zuozhuyvzhibo-maker/Tinyriscv_g11/doc/From RTL to GDS 设计流程讲解（中）.pdf

# From RTL to GDS 设计流程讲解（中）

程子艺，华园，陈虹
THU-SIC
2026年5月

## 清华大学集成电路学院《数字集成电路设计与实践》

目录

- 综合

## - 形式验证

- 布局
- 布线

## 清华大学集成电路学院《数字集成电路设计与实践》

# 布局和布线（一）

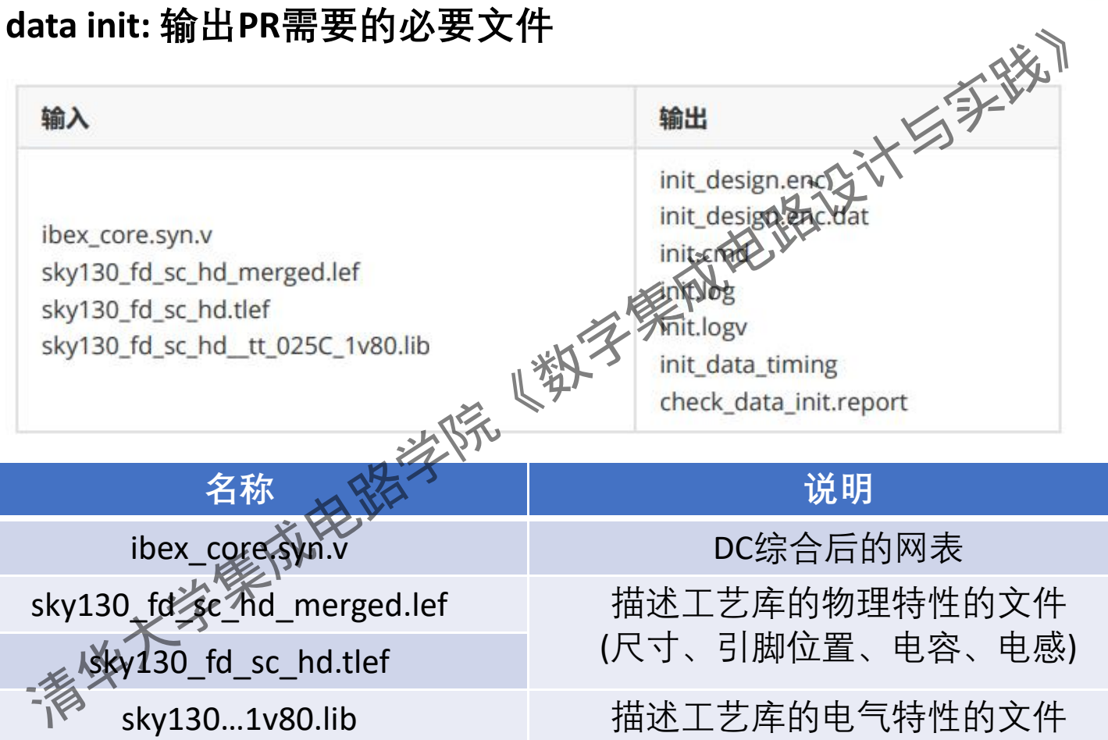
[picture p2: figure]
清华大学集成电路学院《数字集成电路设计与实践》

名称 | 说明
ibex_core.syn.v | DC综合后的网表
sky130_fd_sc_hd_merged.lef | 描述工艺库的物理特性的文件
(尺寸、引脚位置、电容、电感) sky130_fd_sc_hd.tlef
sky130…1v80.lib | 描述工艺库的电气特性的文件 (时序、功耗、电压)
- PR data init: 输出PR需要的必要文件

# 布局和布线（一）

名称 | 说明
init_design.enc | 芯片设计的初始状态信息，
init_design.enc.dat | 如逻辑元素的布局、连接、时序
init.cmd | PR工具的初始化命令和参数
init.log | 记录PR工具的初始化过程和结果
init.logv
init_data_timing | 芯片设计的数据初始化信息，如逻辑 元素的状态、时钟设置
check_data_init.report | 芯片设计的时序分析结果，如时钟频 率、时序路径、时序违规等
- PR data init

## 清华大学集成电路学院《数字集成电路设计与实践》

# 布局和布线（一）

- PR data init

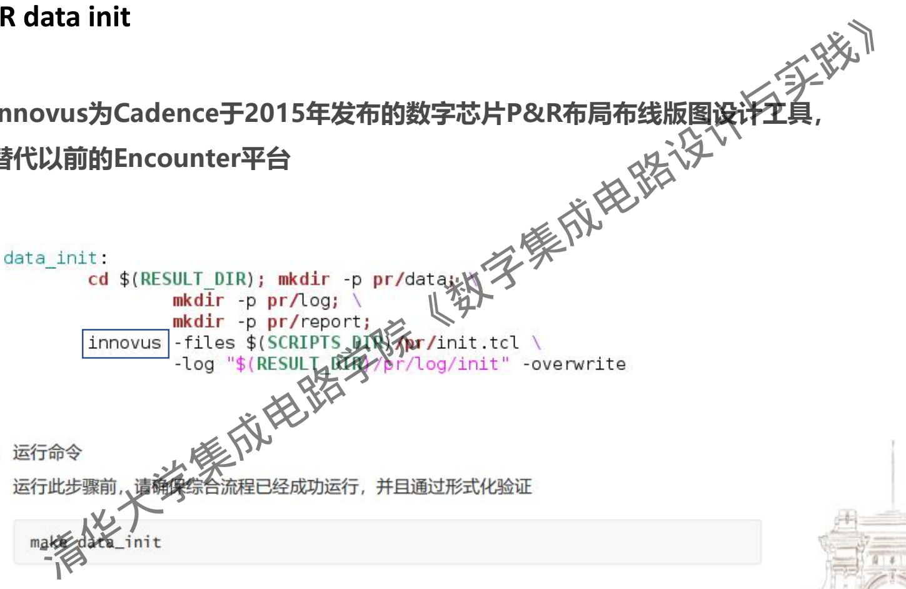
[picture p3: figure]
清华大学集成电路学院《数字集成电路设计与实践》

Innovus为Cadence于2015年发布的数字芯片P&R布局布线版图设计工具， 替代以前的Encounter平台

# 布局和布线（一）

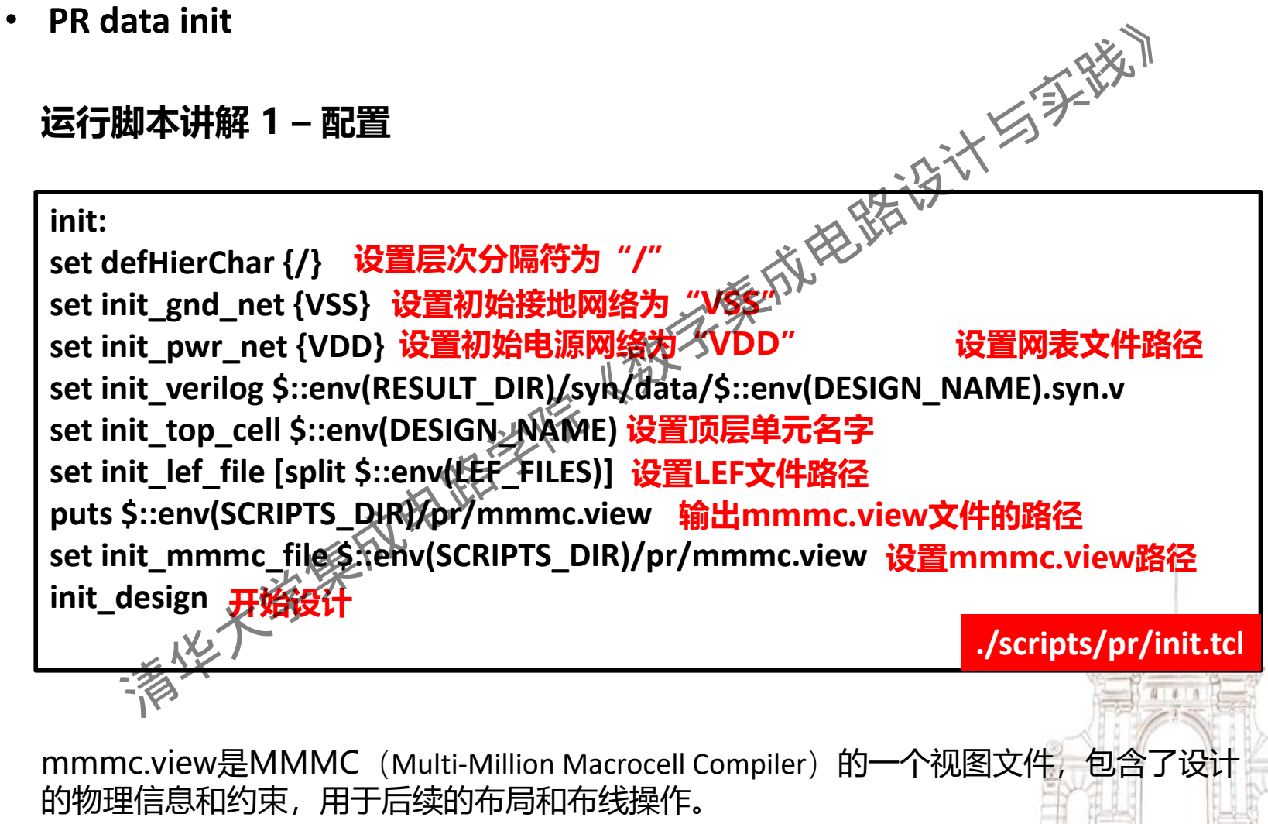
[picture p4: figure]
• PR data init; init: set defHierChar {/} set init_gnd_net {VSS} set init_pwr_net {VDD} set init_verilog $::env(RESULT_DIR)/syn/data/$::env(DESIGN_NAME).syn.v set init_top_cell $::env(DESIGN_NAME) set init_lef_file [split $::env(LEF_FILES)] puts $::env(SCRIPTS_DIR)/pr/mmmc.view set init_mmmc_file $::env(SCRIPTS_DIR)/pr/mmmc.view init_design; ./scripts/pr/init.tcl; 运行脚本讲解 1 – 配置; 设置层次分隔符为“/” 设置初始接地网络为“VSS”; 设置初始电源网络为“VDD”; 设置网表文件路径; 设置顶层单元名字 设置LEF文件路径 输出mmmc.view文件的路径 设置mmmc.view路径; mmmc.view是MMMC（Multi-Million Macrocell Compiler）的一个视图文件，包含了设计 的物理信息和约束，用于后续的布局和布线操作。; 开始设计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

# 布局和布线（一）

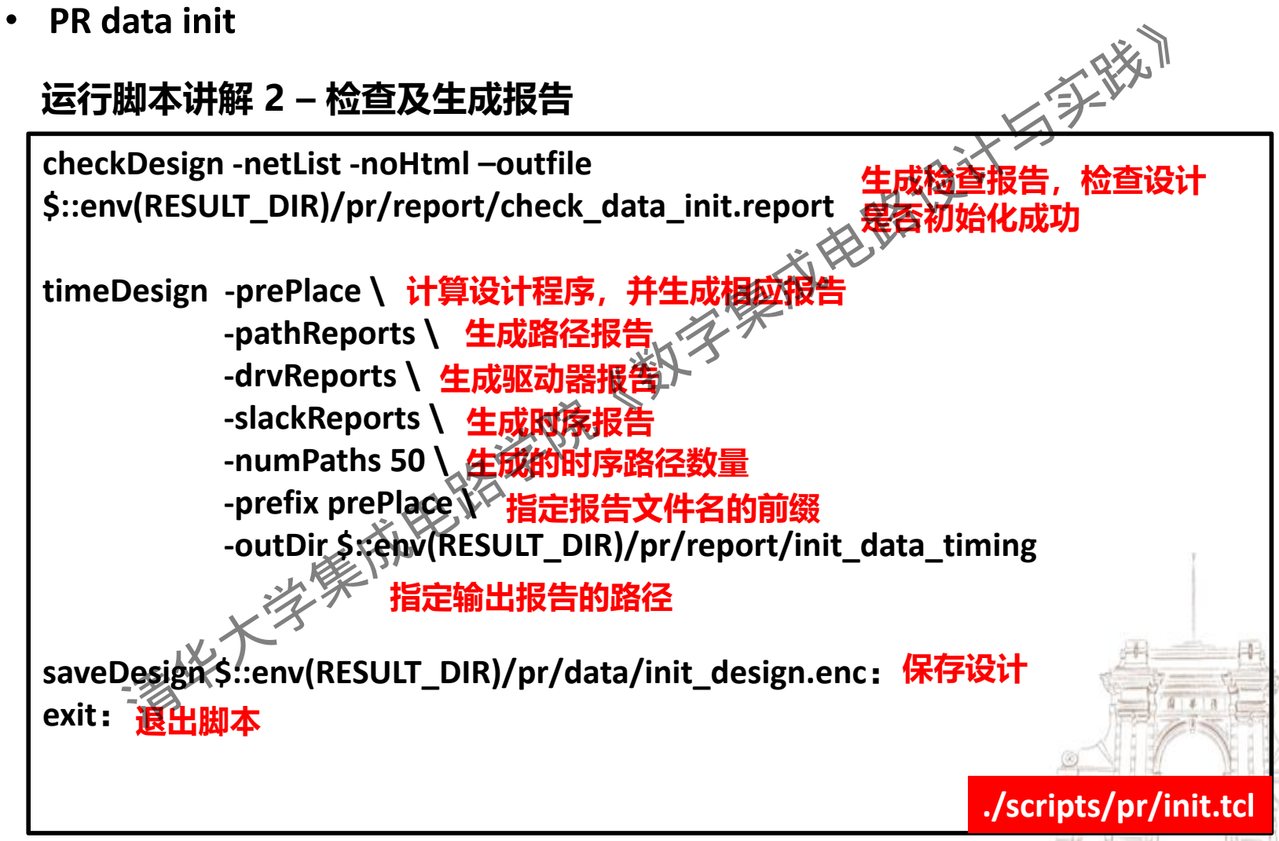
[picture p5: figure]
• PR data init; checkDesign -netList -noHtml –outfile $::env(RESULT_DIR)/pr/report/check_data_init.report; timeDesign -prePlace \ -pathReports \ -drvReports \ -slackReports \ -numPaths 50 \ -prefix prePlace \ -outDir $::env(RESULT_DIR)/pr/report/init_data_timing; saveDesign $::env(RESULT_DIR)/pr/data/init_design.enc： exit：; 运行脚本讲解 2 – 检查及生成报告; ./scripts/pr/init.tcl; 生成检查报告，检查设计 是否初始化成功; 计算设计程序，并生成相应报告 生成路径报告 生成驱动器报告 生成时序报告 生成的时序路径数量 指定报告文件名的前缀; 指定输出报告的路径; 保存设计; 清华大学集成电路学院《数字集成电路设计与实践》; 出脚本

# 布局和布线（一）

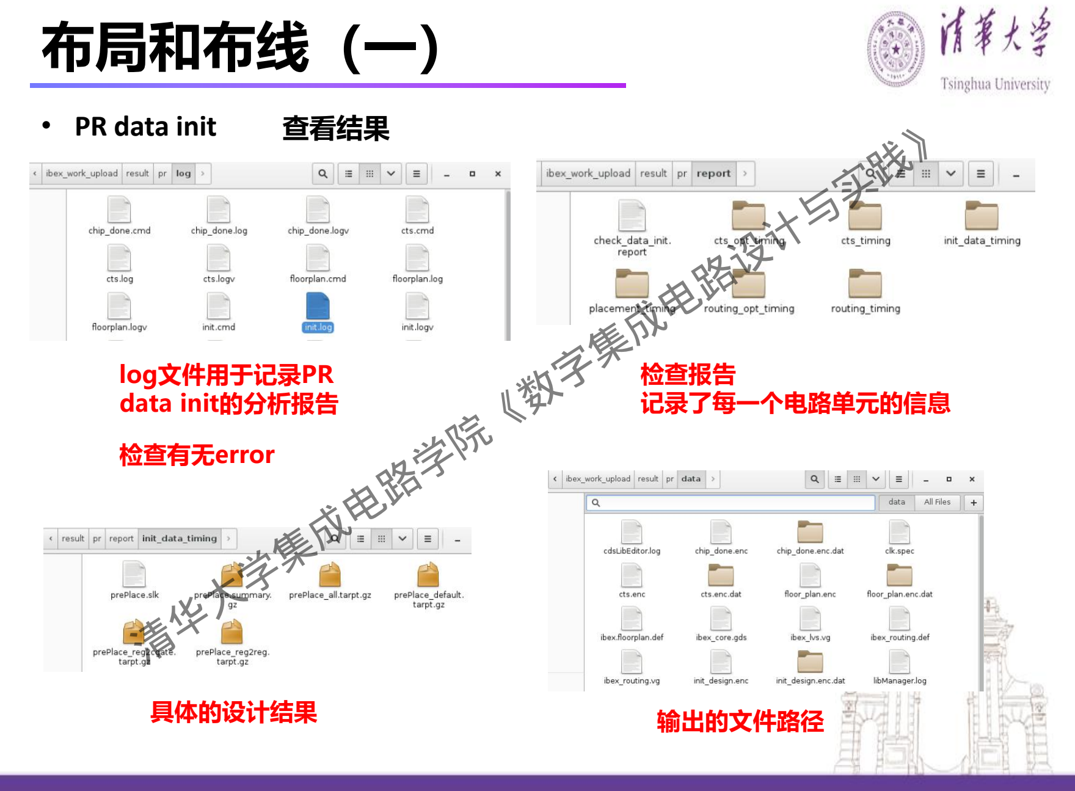
[picture p6: page 8]

- PR data init

log文件用于记录PR
data init的分析报告

查看结果

检查报告
记录了每一个电路单元的信息

具体的设计结果

检查有无error

输出的文件路径

## 清华大学集成电路学院《数字集成电路设计与实践》

# 布局和布线（二）

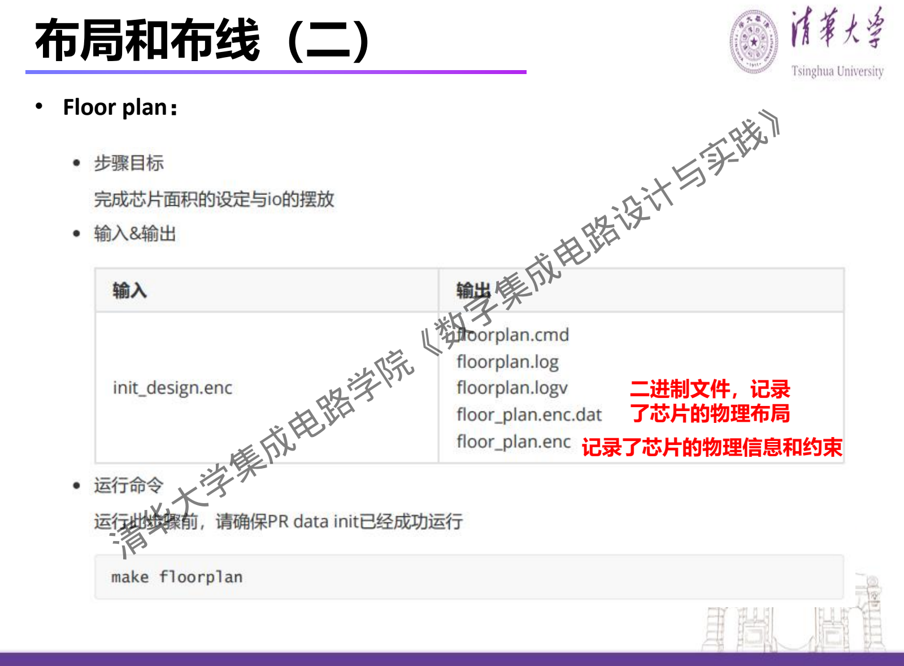
[picture p7: page 9]

- Floor plan：

二进制文件，记录
了芯片的物理布局
记录了芯片的物理信息和约束

## 清华大学集成电路学院《数字集成电路设计与实践》

# 布局和布线（二）

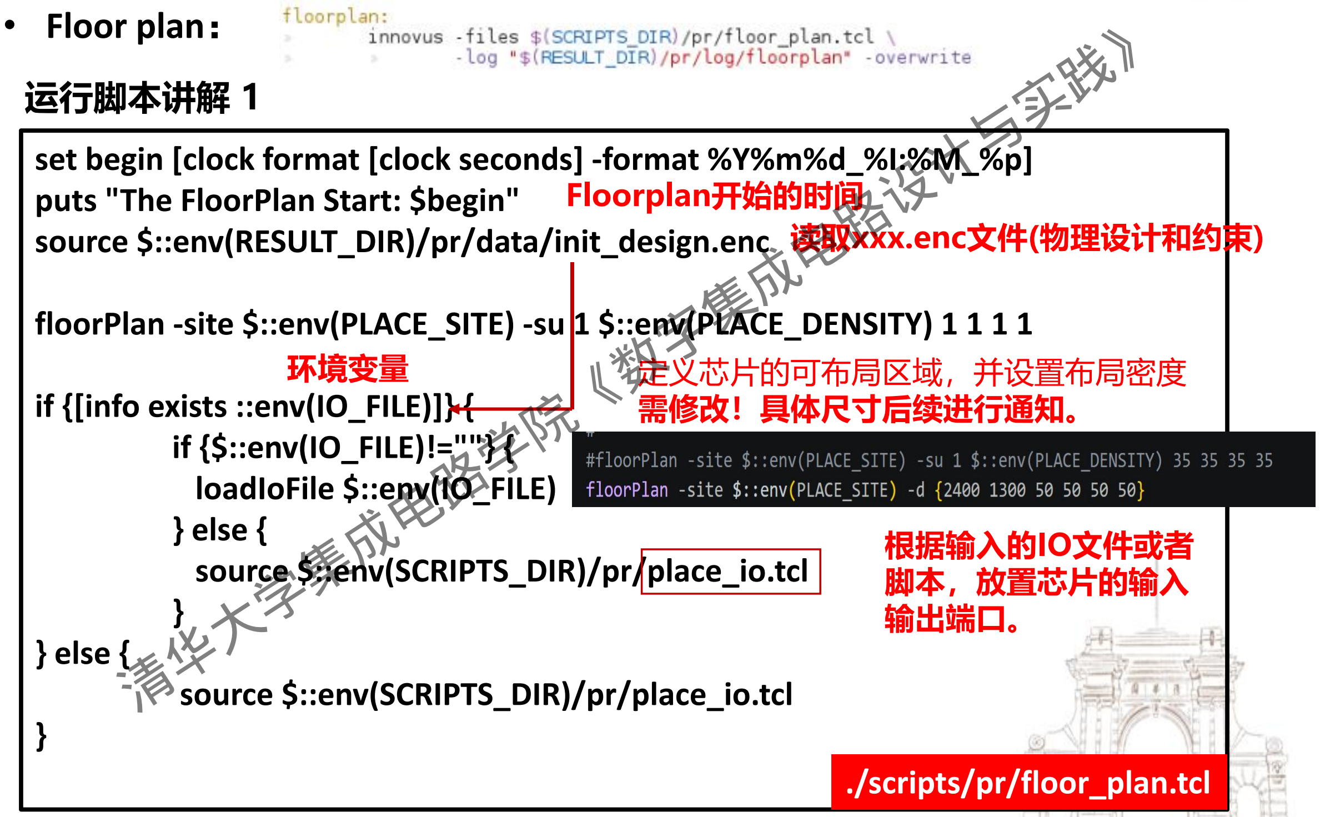
[picture p8: figure]
• Floor plan：; puts "The FloorPlan Start: $begin" source $::env(RESULT_DIR)/pr/data/init_design.enc; if {[info exists ::env(IO_FILE)]} { if {$::env(IO_FILE)!=""} { loadIoFile $::env(IO_FILE) } else { source $::env(SCRIPTS_DIR)/pr/place_io.tcl; } else {; source $::env(SCRIPTS_DIR)/pr/place_io.tcl; ./scripts/pr/floor_plan.tcl; Floorplan开始的时间 读取xxx.enc文件(物理设计和约束); 定义芯片的可布局区域，并设置布局密度 需修改！具体尺寸后续进行通知。; 根据输入的IO文件或者 脚本，放置芯片的输入 输出端口。; 环境变量; 运行脚本讲解 1; 清华大学集成电路学院《数字集成电路设计与实践》

set begin [clock format [clock seconds] -format %Y%m%d_%I:%M_%p]

floorPlan -site $::env(PLACE_SITE) -su 1 $::env(PLACE_DENSITY) 1 1 1 1

# 布局和布线（二）

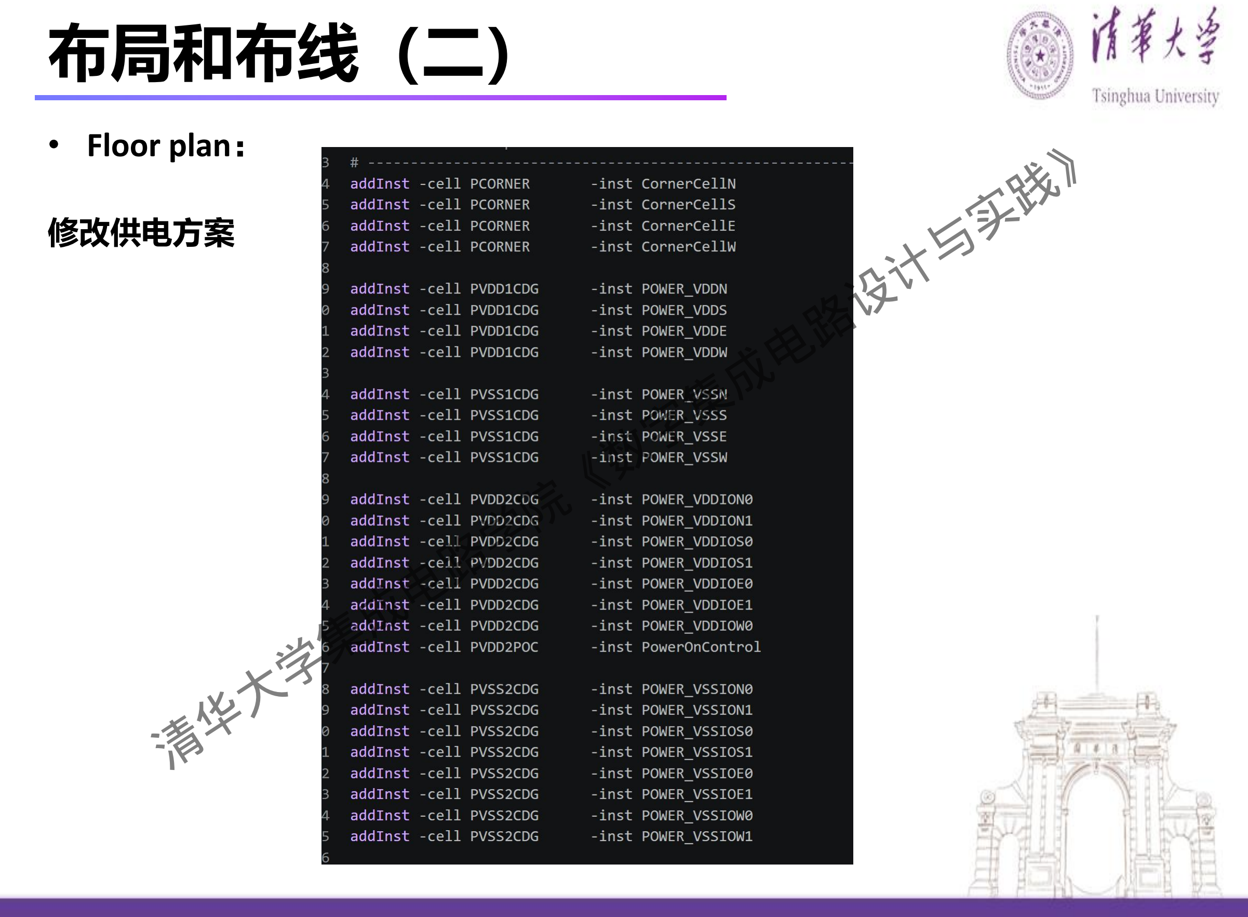
[picture p9: page 11]

修改供电方案

- Floor plan：

## 清华大学集成电路学院《数字集成电路设计与实践》

# 布局和布线（二）

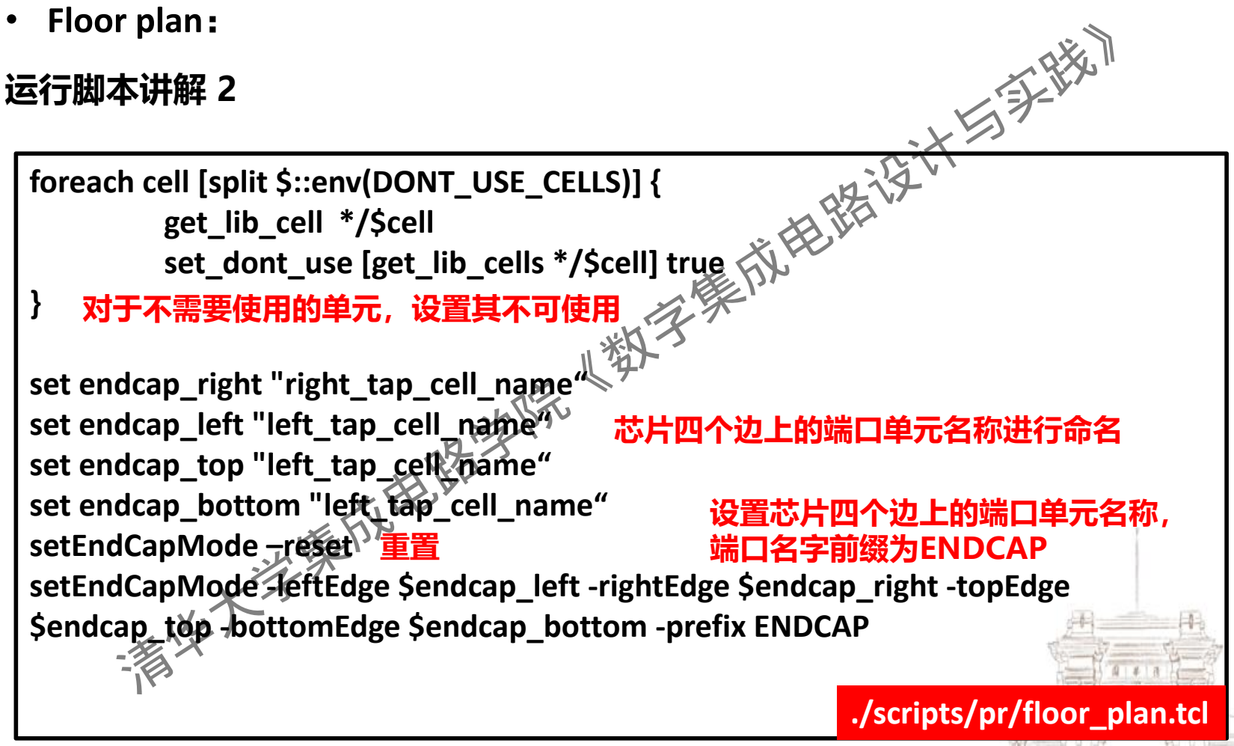
[picture p10: figure]
运行脚本讲解 2; foreach cell [split $::env(DONT_USE_CELLS)] { get_lib_cell */$cell set_dont_use [get_lib_cells */$cell] true; set endcap_right "right_tap_cell_name“ set endcap_left "left_tap_cell_name“ set endcap_top "left_tap_cell_name“ set endcap_bottom "left_tap_cell_name“ setEndCapMode –reset; $endcap_top -bottomEdge $endcap_bottom -prefix ENDCAP; ./scripts/pr/floor_plan.tcl; 对于不需要使用的单元，设置其不可使用; 芯片四个边上的端口单元名称进行命名; 设置芯片四个边上的端口单元名称， 端口名字前缀为ENDCAP; • Floor plan： 清华大学集成电路学院《数字集成电路设计与实践》

setEndCapMode -leftEdge $endcap_left -rightEdge $endcap_right -topEdge

# 布局和布线（二）

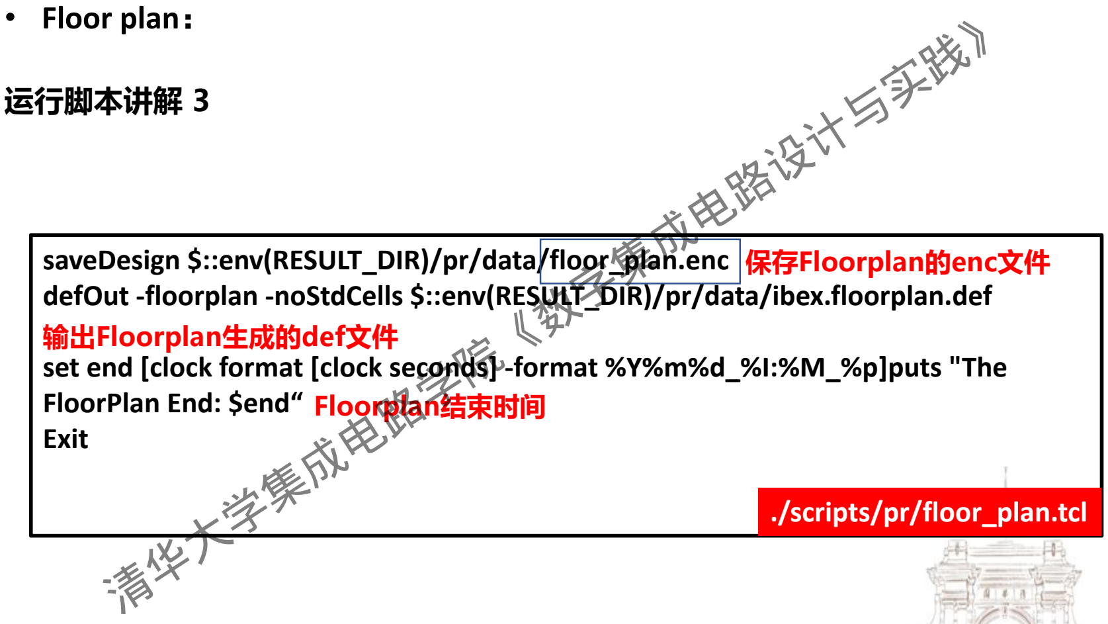
[picture p11: figure]
运行脚本讲解 3; saveDesign $::env(RESULT_DIR)/pr/data/floor_plan.enc defOut -floorplan -noStdCells $::env(RESULT_DIR)/pr/data/ibex.floorplan.def; FloorPlan End: $end“ Exit; ./scripts/pr/floor_plan.tcl; 保存Floorplan的enc文件; 输出Floorplan生成的def文件; Floorplan结束时间; • Floor plan： 清华大学集成电路学院《数字集成电路设计与实践》

set end [clock format [clock seconds] -format %Y%m%d_%I:%M_%p]puts "The

# 布局和布线（二）

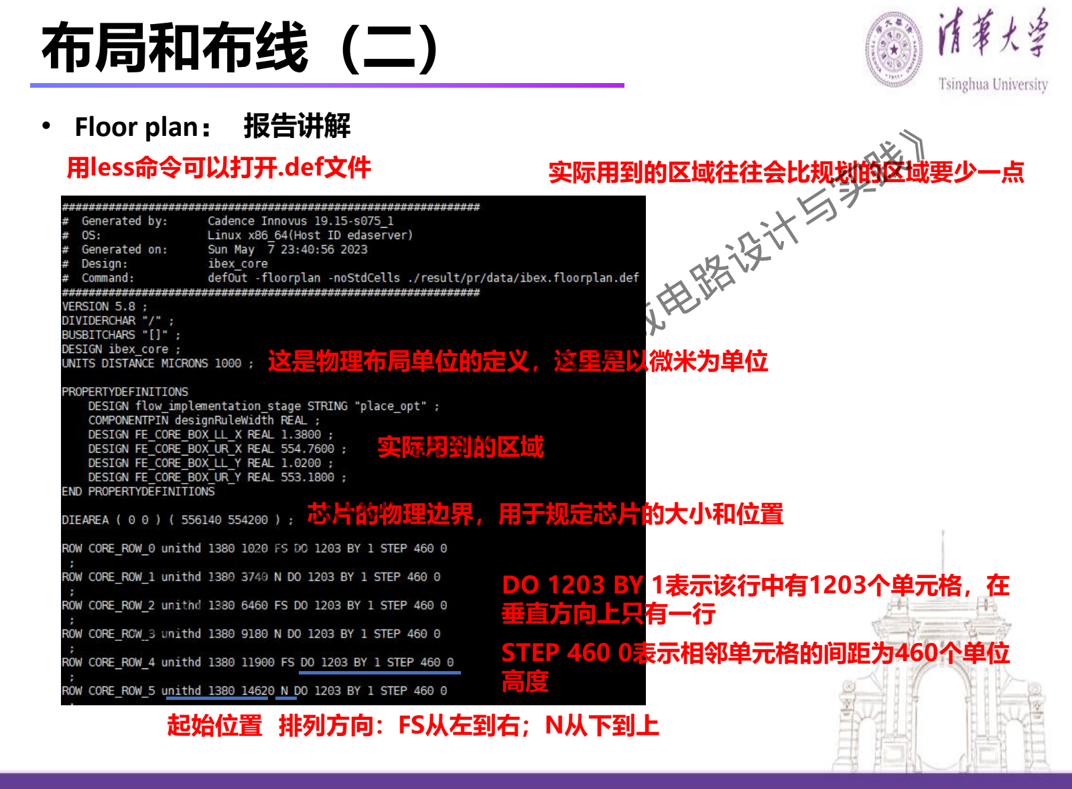
[picture p12: page 14]

- Floor plan：
用less命令可以打开.def文件

这是物理布局单位的定义，这里是以微米为单位

芯片的物理边界，用于规定芯片的大小和位置

实际用到的区域

实际用到的区域往往会比规划的区域要少一点

起始位置 排列方向：FS从左到右；N从下到上

DO 1203 BY 1表示该行中有1203个单元格，在 垂直方向上只有一行
STEP 460 0表示相邻单元格的间距为460个单位 高度

报告讲解

## 清华大学集成电路学院《数字集成电路设计与实践》

# 布局和布线（三）

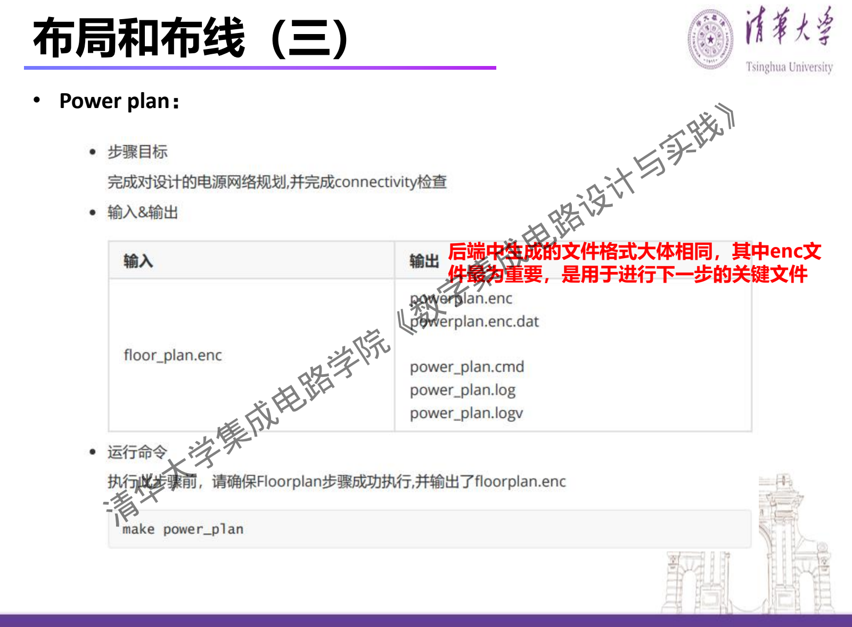
[picture p13: page 15]

- Power plan：

后端中生成的文件格式大体相同，其中enc文
件最为重要，是用于进行下一步的关键文件

## 清华大学集成电路学院《数字集成电路设计与实践》

# 布局和布线（三）

- Power plan：

运行脚本讲解 1

source $::env(RESULT_DIR)/pr/data/floor_plan.enc
# ------------------------------------------------------------- # Global PG net connect

# ------------------------------------------------------------- globalNetConnect VDD -type pgpin -pin "$::env(PWR_PORT)" -inst *

globalNetConnect VDD -type tiehi -pin "$::env(PWR_PORT)" -inst * globalNetConnect VDD -type net -net VDD
globalNetConnect VSS -type pgpin -pin "$::env(GND_PORT)" -inst * globalNetConnect VSS -type tielo -pin "$::env(GND_PORT)" -inst * globalNetConnect VSS -type net -net VSS

./scripts/pr/power_plan.tcl

导入floorplan.enc文件

将VDD全局电源连到所有单元的pgpin和tiehi类型引脚上

将VDD全局电源引脚连接到VDD电源网络

VSS同

## 清华大学集成电路学院《数字集成电路设计与实践》

上

# 布局和布线（三）

- Power plan：
类型 | 引脚 | 解释
pgpin | 电源-地 | pgpin被用于连接电源和地面引脚。它们通 常是在芯片的周边区域放置的，以便方便 地连接到电源和地面网络。
tiehi | 电源-芯片内部 | tiehi被用于将电源引脚连接到芯片内部的电 源网络。它通常被用于芯片的电源引脚， 以便将电源引脚连接到芯片内部的电源网 络。 tiehi引脚的作用是提供一个低阻抗的路径， 以确保电源信号能够在芯片内部快速传输。

## 清华大学集成电路学院《数字集成电路设计与实践》

# 布局和布线（三）

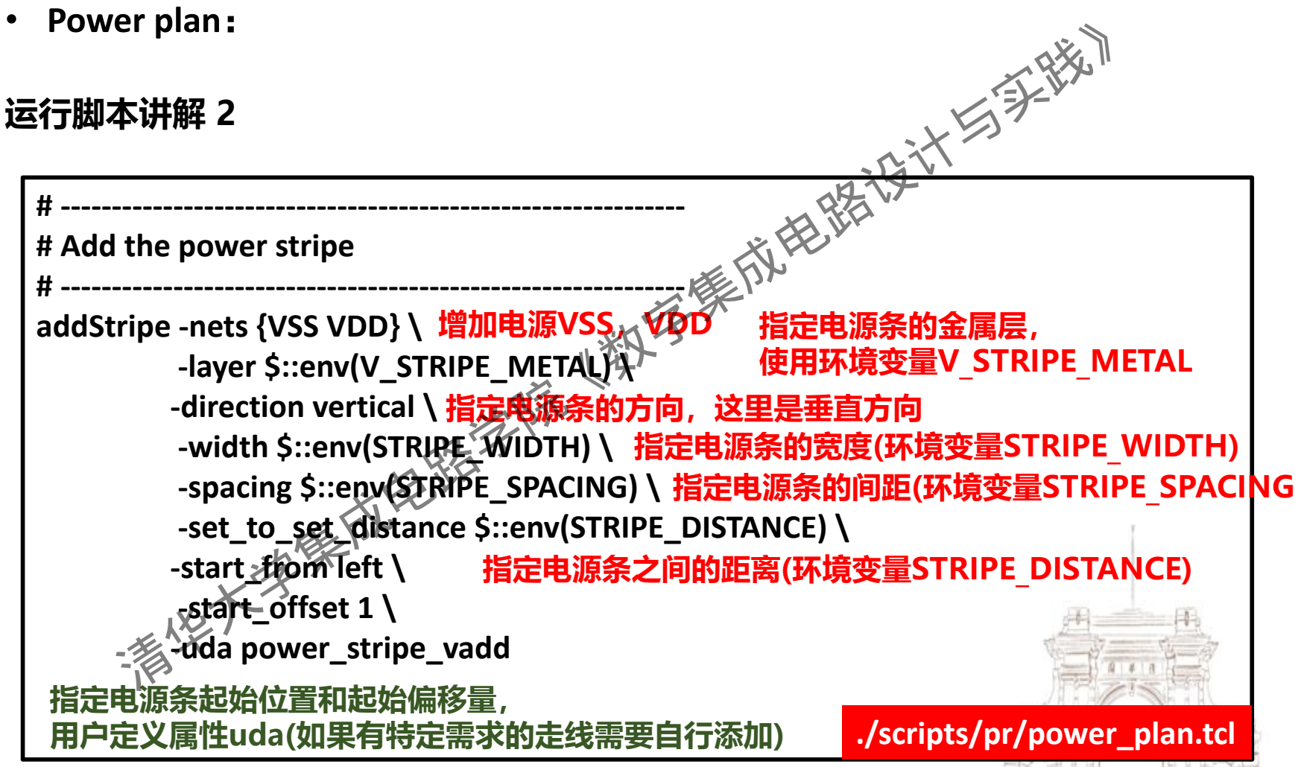
[picture p14: figure]
• Power plan：; 运行脚本讲解 2; -layer $::env(V_STRIPE_METAL) \ -direction vertical \ -width $::env(STRIPE_WIDTH) \ -spacing $::env(STRIPE_SPACING) \ -set_to_set_distance $::env(STRIPE_DISTANCE) \ -start_from left \ -start_offset 1 \ -uda power_stripe_vadd; ./scripts/pr/power_plan.tcl; 增加电源VSS，VDD 指定电源条的金属层， 使用环境变量V_STRIPE_METAL 指定电源条的方向，这里是垂直方向 指定电源条的宽度(环境变量STRIPE_WIDTH) 指定电源条的间距(环境变量STRIPE_SPACING); 指定电源条之间的距离(环境变量STRIPE_DISTANCE); 指定电源条起始位置和起始偏移量， 用户定义属性uda(如果有特定需求的走线需要自行添加); 清华大学集成电路学院《数字集成电路设计与实践》

# ------------------------------------------------------------- # Add the power stripe # ------------------------------------------------------------- addStripe -nets {VSS VDD} \

# 布局和布线（三）

- Power plan：

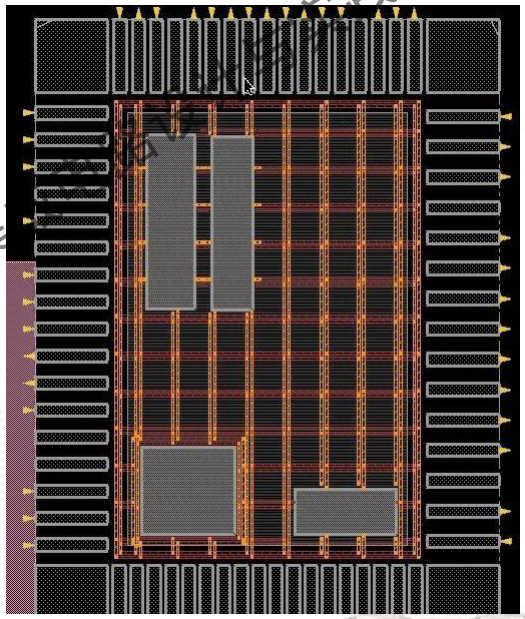
[picture p15: figure]

Power Stripe。中文名就是电源条线。我们把芯 片core里面纵横交错的电源网格称为
Power stripe。

它的作用就是给design中的hard macro以及 power rail供电，将电源信息传递给core里面各 个角落。

通常按照一定的pattern规律添加，基本都会选用
高层金属走线。因为高层金属具有较小的电阻，
可以有效的降低IR drop的影响。对于power
stripe宽度和间距设计。通常受到不同工艺的影
响，区别会比较大，

## 清华大学集成电路学院《数字集成电路设计与实践》

# 布局和布线（三）

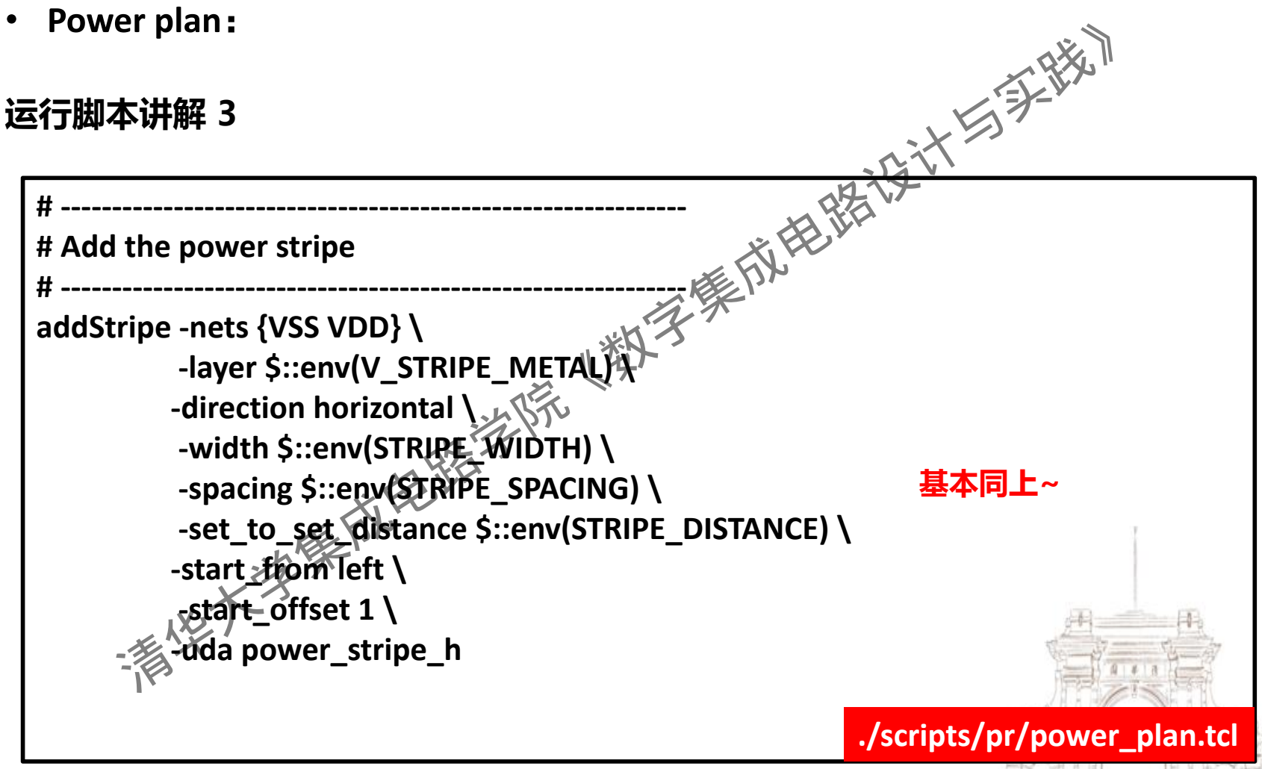
[picture p16: figure]
• Power plan：; 运行脚本讲解 3; -layer $::env(V_STRIPE_METAL) \ -direction horizontal \ -width $::env(STRIPE_WIDTH) \ -spacing $::env(STRIPE_SPACING) \ -set_to_set_distance $::env(STRIPE_DISTANCE) \ -start_from left \ -start_offset 1 \ -uda power_stripe_h; ./scripts/pr/power_plan.tcl; 基本同上~; 清华大学集成电路学院《数字集成电路设计与实践》

# ------------------------------------------------------------- # Add the power stripe # ------------------------------------------------------------- addStripe -nets {VSS VDD} \

# 布局和布线（三）

- Power plan：
运行脚本讲解 4

# ------------------------------------------------------------- # Add the power rail

# ------------------------------------------------------------- set sroute_min_layer $::env(SROUTE_MIN_LAYER) set sroute_max_layer $::env(SROUTE_MAX_LAYER) sroute -connect { corePin } \

-layerChangeRange " $sroute_min_layer $sroute_max_layer " \ -corePinTarget { none } \
-allowJogging 1 \
-crossoverViaLayerRange " $sroute_min_layer $sroute_max_layer " \ -nets { VDD VSS } \
-allowLayerChange 1 \
-targetViaLayerRange " $sroute_min_layer $sroute_max_layer " \
-uda power_rail | ./scripts/pr/power_plan.tcl

添加电源轨

指定电源轨布线时使用的最小
和最大金属层数量
执行电源轨的布线，将其连接到核心引脚（corePin）上 指定电源轨的
表示在布线时不考虑核心引脚的位置 | 金属层范围
允许电源轨在布线时出现拐点，以适应布线的需要 | 指定电源轨
的穿越金属
指定连接的电源网络，即VDD和VSS | 层范围
允许电源轨在布线时切换金属层，以适应布线的需要

## 清华大学集成电路学院《数字集成电路设计与实践》

指定电源轨的目标金属层范围

# 布局和布线（三）

- Power plan：

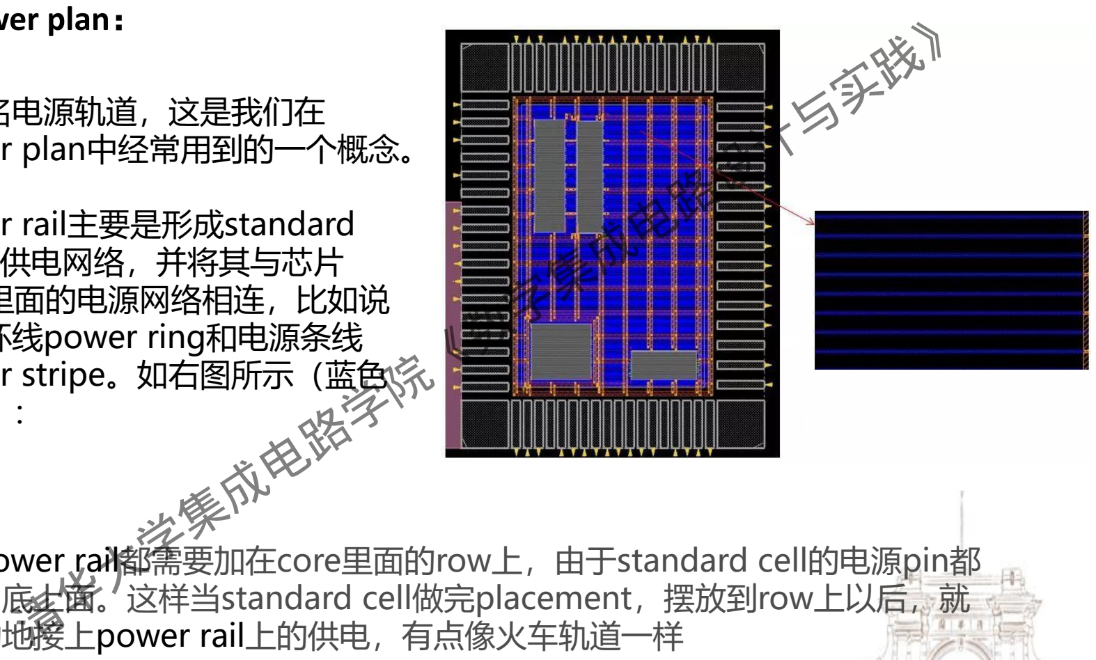
[picture p17: figure]
清华大学集成电路学院《数字集成电路设计与实践》; 接上power rail上的供电，有点像火车轨道一样

中文名电源轨道，这是我们在
power plan中经常用到的一个概念。

power rail主要是形成standard
cell的供电网络，并将其与芯片
core里面的电源网络相连，比如说
电源环线power ring和电源条线
power stripe。如右图所示（蓝色
部分）：

每条power rail都需要加在core里面的row上，由于standard cell的电源pin都 在顶和底上面。这样当standard cell做完placement，摆放到row上以后，就 能自动地

# 布局和布线（三）

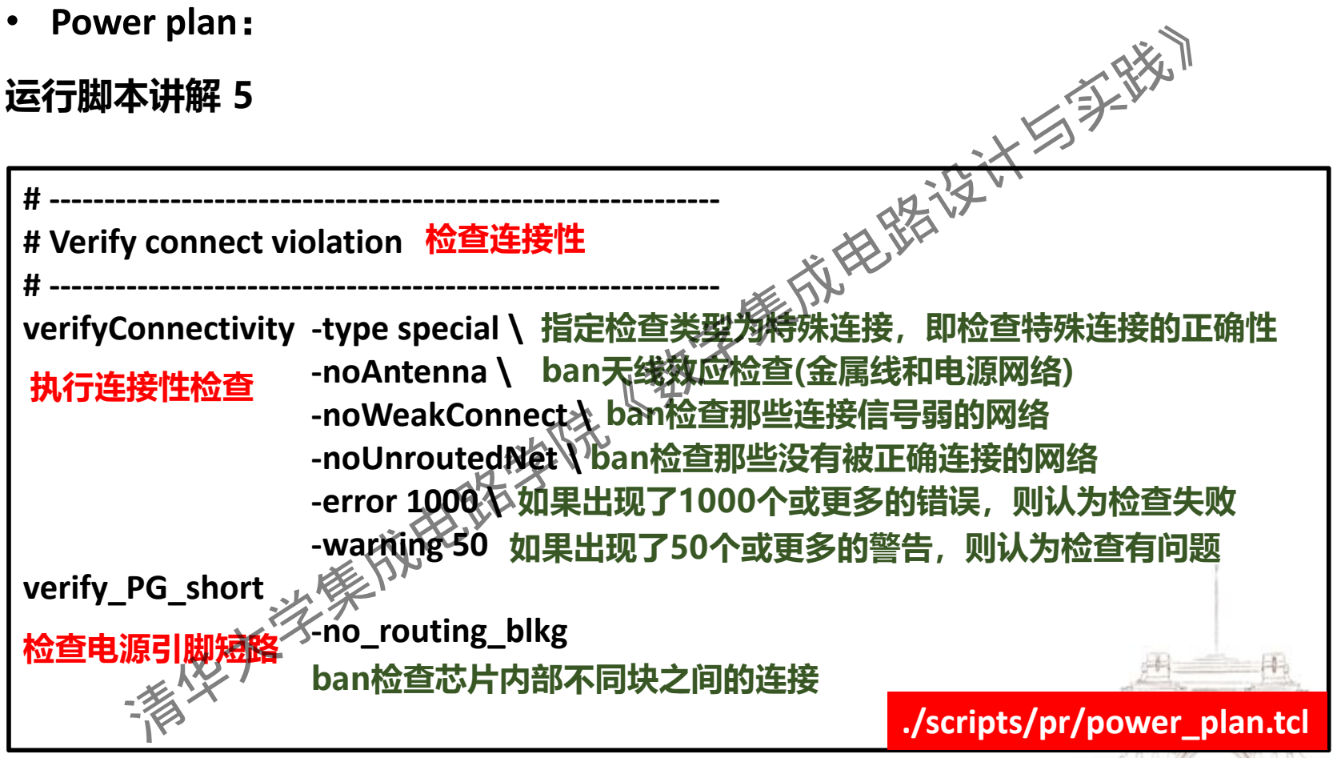
[picture p18: figure]
• Power plan：; 运行脚本讲解 5; -noAntenna \ -noWeakConnect \ -noUnroutedNet \ -error 1000 \ -warning 50; verify_PG_short; -no_routing_blkg; ./scripts/pr/power_plan.tcl; 检查连接性; 指定检查类型为特殊连接，即检查特殊连接的正确性 ban天线效应检查(金属线和电源网络) ban检查那些连接信号弱的网络 ban检查那些没有被正确连接的网络 如果出现了1000个或更多的错误，则认为检查失败 如果出现了50个或更多的警告，则认为检查有问题; 检查电源引脚短路; 执行连接性检查; ban检查芯片内部不同块之间的连接; 清华大学集成电路学院《数字集成电路设计与实践》

# ------------------------------------------------------------- # Verify connect violation # ------------------------------------------------------------- verifyConnectivity -type special \

# 布局和布线（三）

- Power plan：

天线效应（antenna effect）是指金属线和电源网络之间的相互作用，通常会导 致信号干扰和电源噪声等问题。

在芯片生产过程中，暴露的金属线或者多晶硅(polysilicon)等导体，就象是一根根 天线，会收集电荷（如等离子刻蚀产生的带电粒子）导致电位升高。

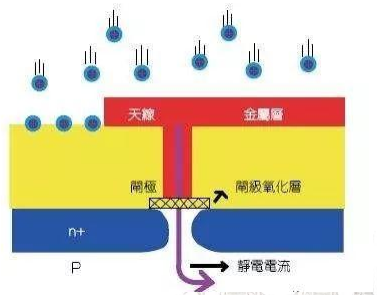
[picture p19: figure]

天线越长，收集的电荷也就越多，电压就越
高。若这片导体碰巧只接了MOS 的栅，那
么高电压就可能把薄栅氧化层击穿，使电路
失效，这种现象我们称之为“天线效应”。

## 清华大学集成电路学院《数字集成电路设计与实践》

# 布局和布线（三）

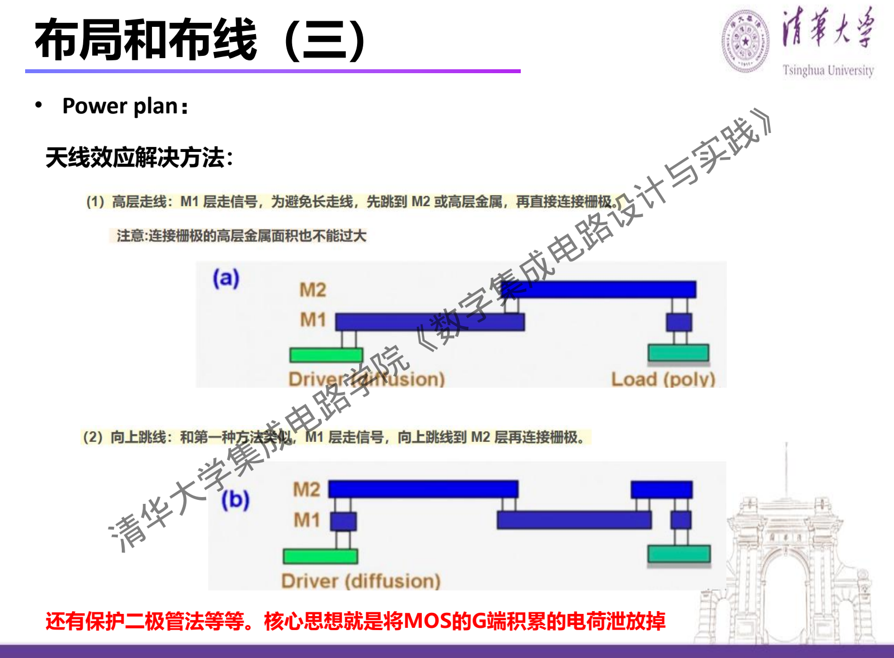
[picture p20: page 25]

- Power plan：

天线效应解决方法：

还有保护二极管法等等。核心思想就是将MOS的G端积累的电荷泄放掉

## 清华大学集成电路学院《数字集成电路设计与实践》

# 布局和布线（三）

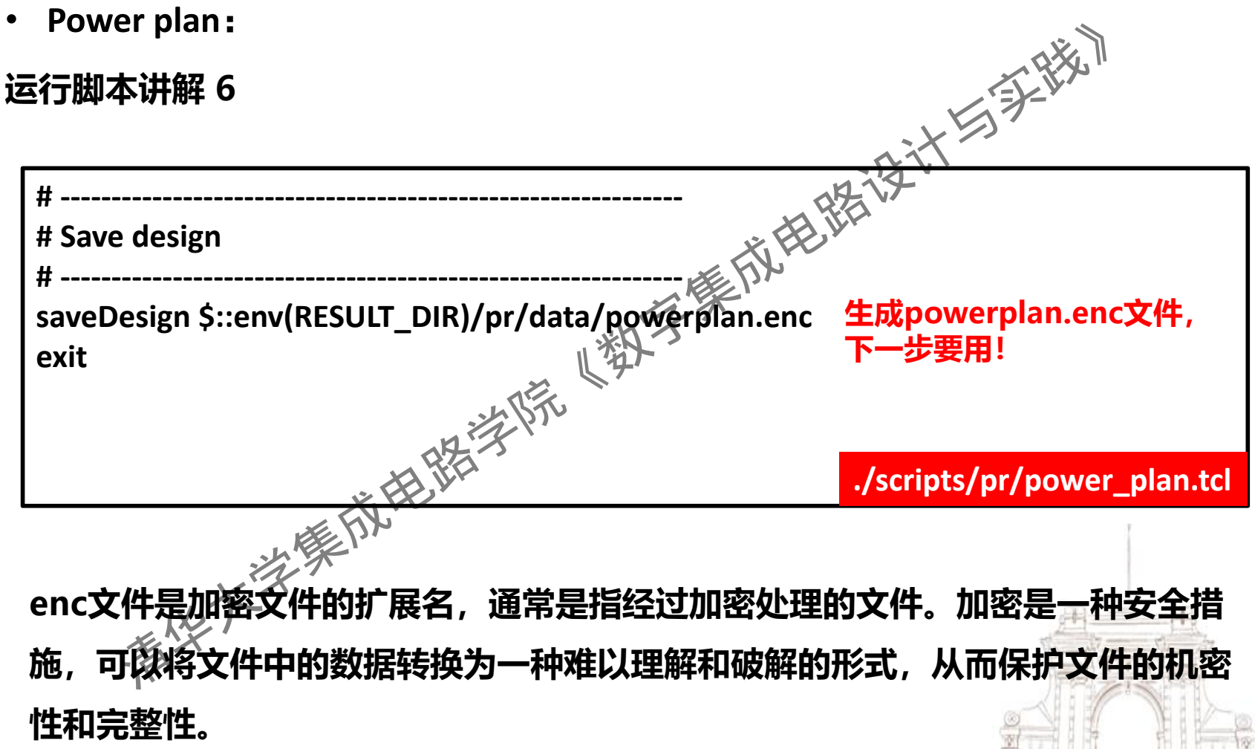
[picture p21: figure]
• Power plan：; 运行脚本讲解 6; # ------------------------------------------------------------- # Save design; # ------------------------------------------------------------- saveDesign $::env(RESULT_DIR)/pr/data/powerplan.enc; exit; ./scripts/pr/power_plan.tcl; 生成powerplan.enc文件， 下一步要用！; enc文件是加密文件的扩展名，通常是指经过加密处理的文件。加密是一种安全措 施，可以将文件中的数据转换为一种难以理解和破解的形式，从而保护文件的机密 性和完整性。; 清华大学集成电路学院《数字集成电路设计与实践》

# 布局和布线（三）

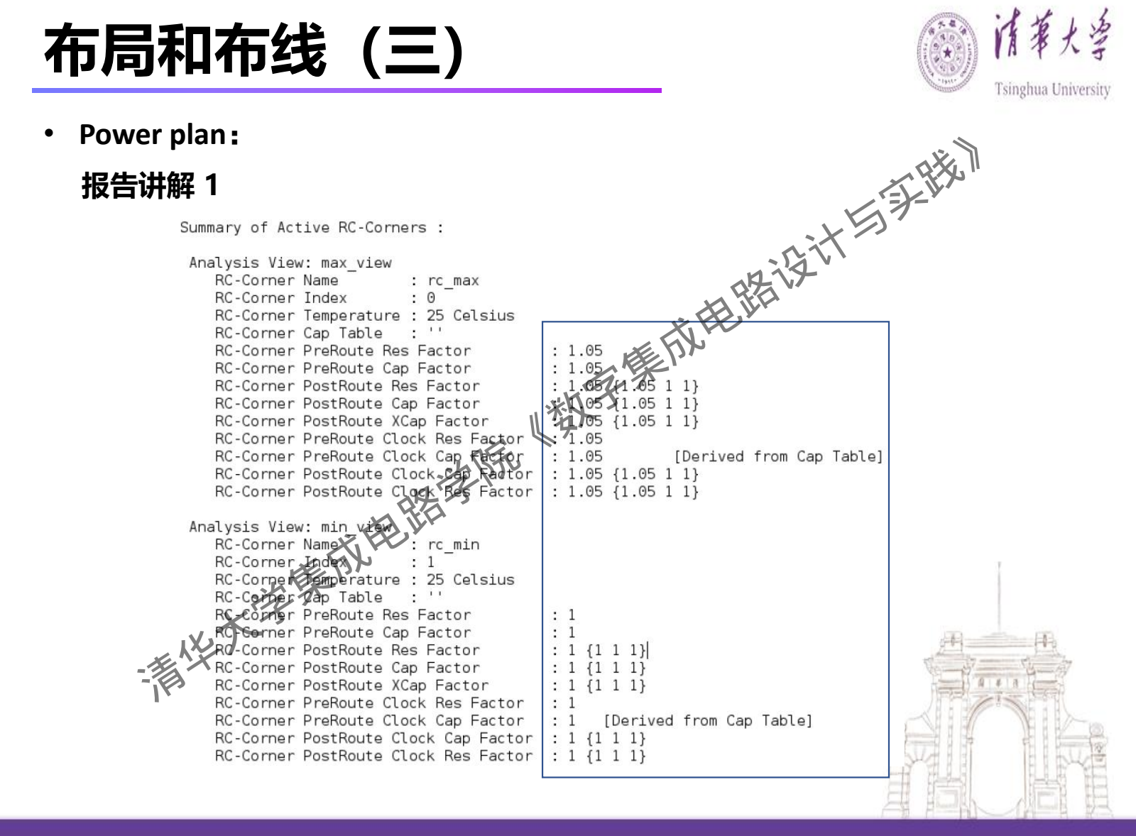
[picture p22: page 27]

- Power plan：
报告讲解 1

## 清华大学集成电路学院《数字集成电路设计与实践》

# 布局和布线（三）

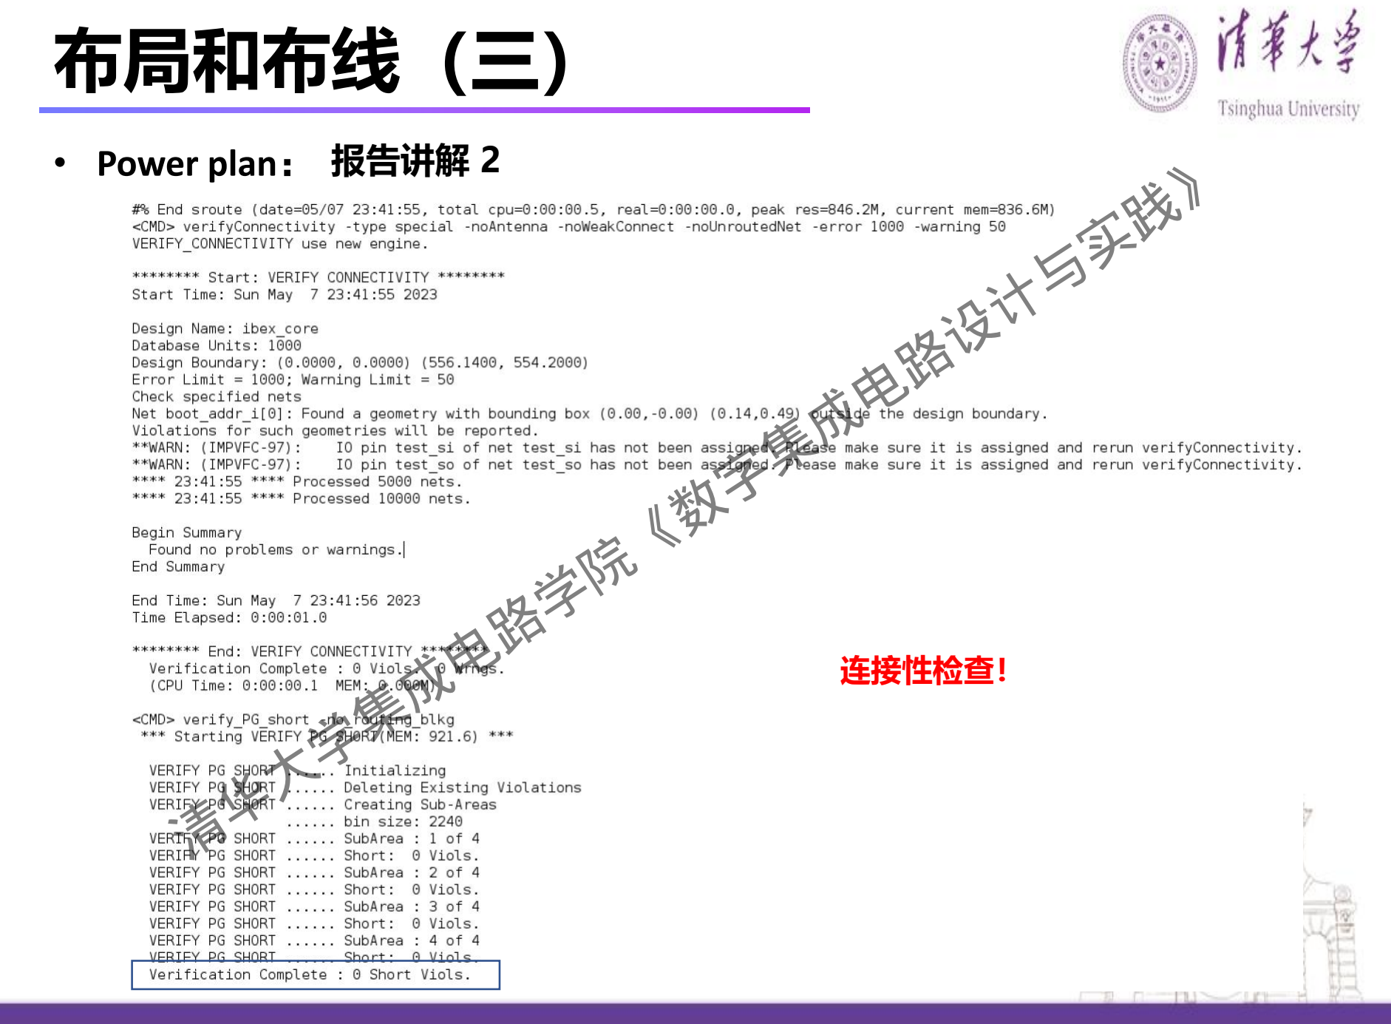
[picture p23: page 28]

- Power plan：

连接性检查！

报告讲解 2

## 清华大学集成电路学院《数字集成电路设计与实践》

# 布局和布线（三）

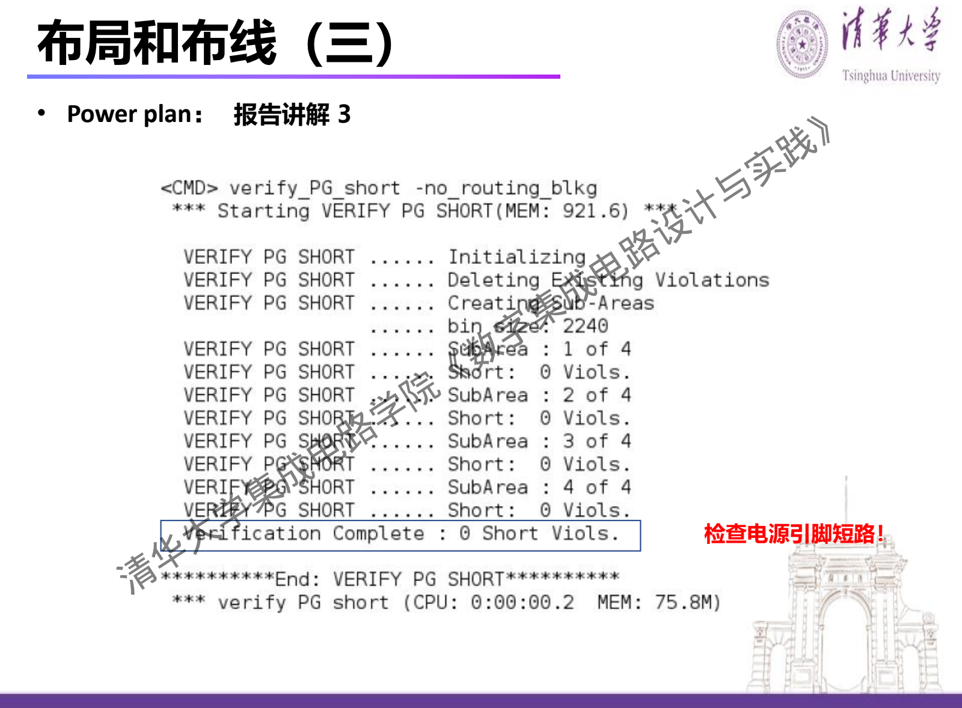
[picture p24: page 29]

- Power plan：

检查电源引脚短路！

报告讲解 3

## 清华大学集成电路学院《数字集成电路设计与实践》

# 布局和布线（四）

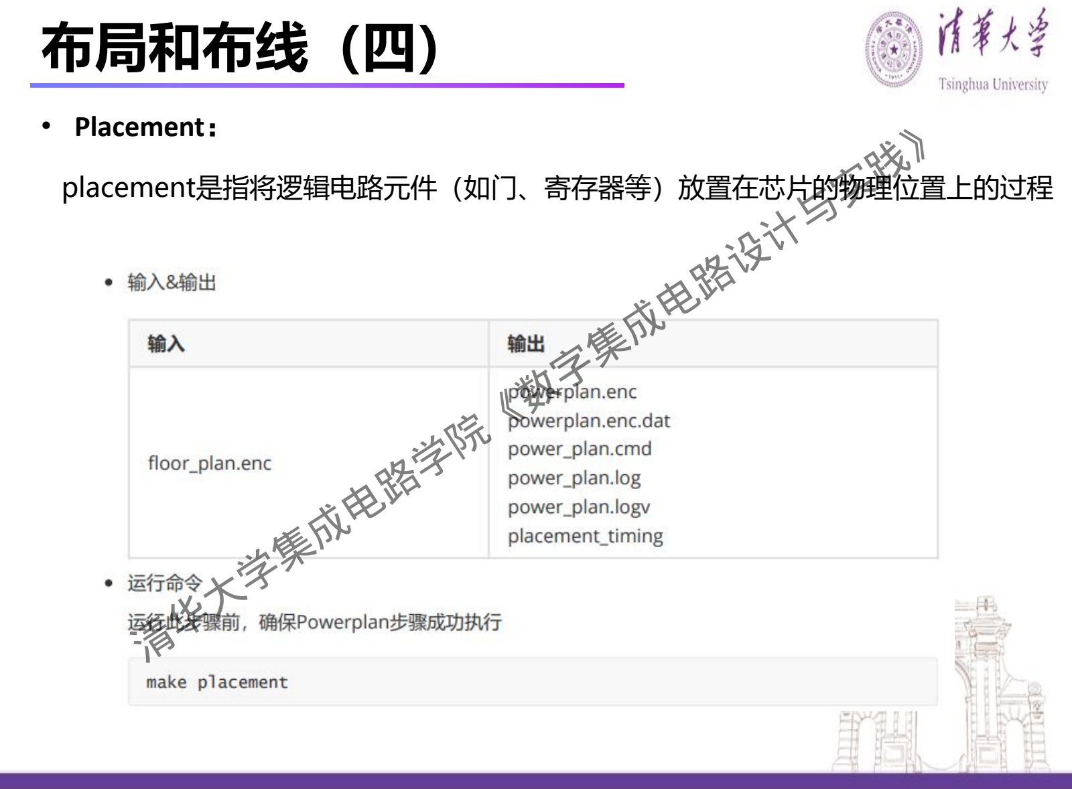
[picture p25: page 30]

- Placement：

placement是指将逻辑电路元件（如门、寄存器等）放置在芯片的物理位置上的过程

## 清华大学集成电路学院《数字集成电路设计与实践》

# 布局和布线（四）

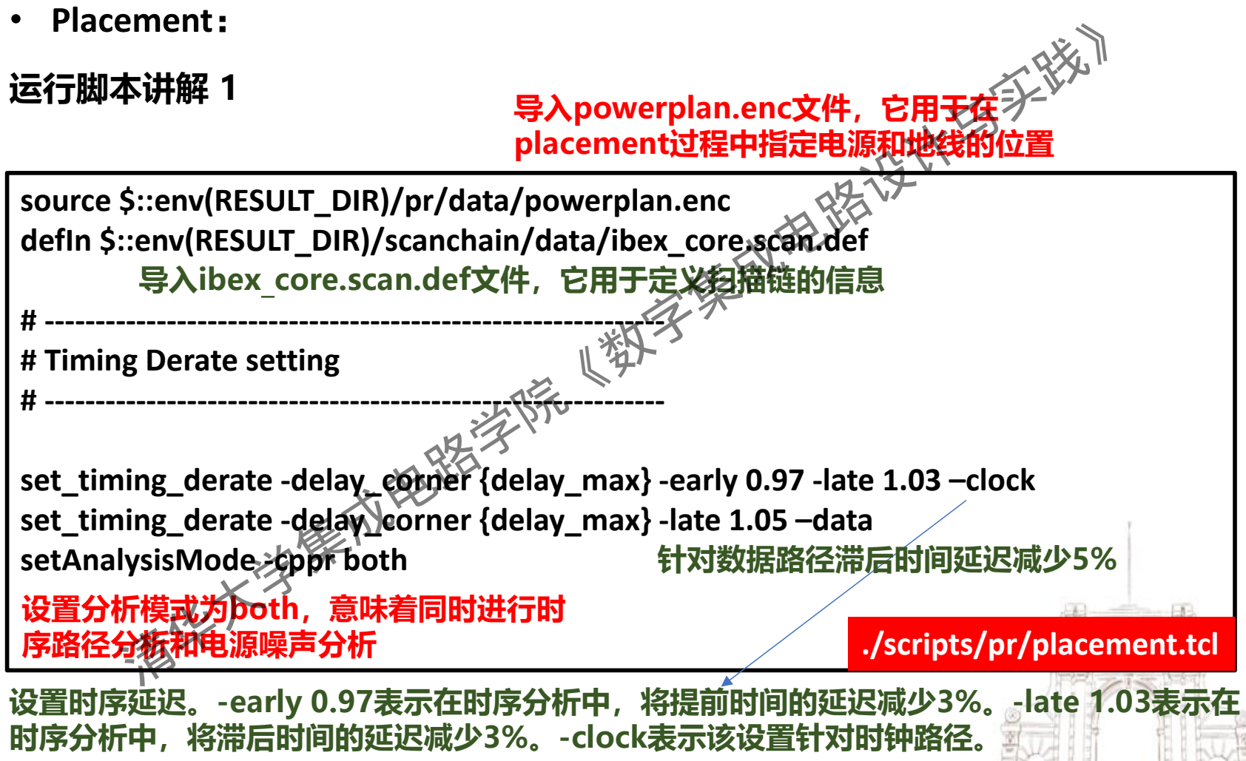
[picture p26: figure]
• Placement：; 运行脚本讲解 1; source $::env(RESULT_DIR)/pr/data/powerplan.enc defIn $::env(RESULT_DIR)/scanchain/data/ibex_core.scan.def; setAnalysisMode -cppr both; ./scripts/pr/placement.tcl; 导入powerplan.enc文件，它用于在 placement过程中指定电源和地线的位置; 导入ibex_core.scan.def文件，它用于定义扫描链的信息; 设置时序延迟。-early 0.97表示在时序分析中，将提前时间的延迟减少3%。-late 1.03表示在 时序分析中，将滞后时间的延迟减少3%。-clock表示该设置针对时钟路径。; 针对数据路径滞后时间延迟减少5%; 设置分析模式为both，意味着同时进行时 序路径分析和电源噪声分析; 清华大学集成电路学院《数字集成电路设计与实践》

# ------------------------------------------------------------- # Timing Derate setting

# ------------------------------------------------------------- set_timing_derate -delay_corner {delay_max} -early 0.97 -late 1.03 –clock

set_timing_derate -delay_corner {delay_max} -late 1.05 –data

# 布局和布线（四）

- Placement：
运行脚本讲解 2

# ------------------------------------------------------------- # Path group setting

# ------------------------------------------------------------- reset_path_group –all

set reg [filter_collection [all_registers] "is_integrated_clock_gating_cell != true"]
set input [all_inputs]
set output [all_outputs]
set ckgating [filter_collection [all_registers] "is_integrated_clock_gating_cell == true"] set ignore_path_groups [list inp2reg reg2out reg2out feedthr]

./scripts/pr/placement.tcl

重置所有的路径信息 定义寄存器变量，包括非时钟门控的寄存器

定义输入/输出变量，包括所有的输入/输出信号

定义寄存器变量，包括时钟门控的寄存器

定义一个忽略路径组的变量，其中包含inp2reg、reg2out、feedthr等路径组。

## 清华大学集成电路学院《数字集成电路设计与实践》

# 布局和布线（四）

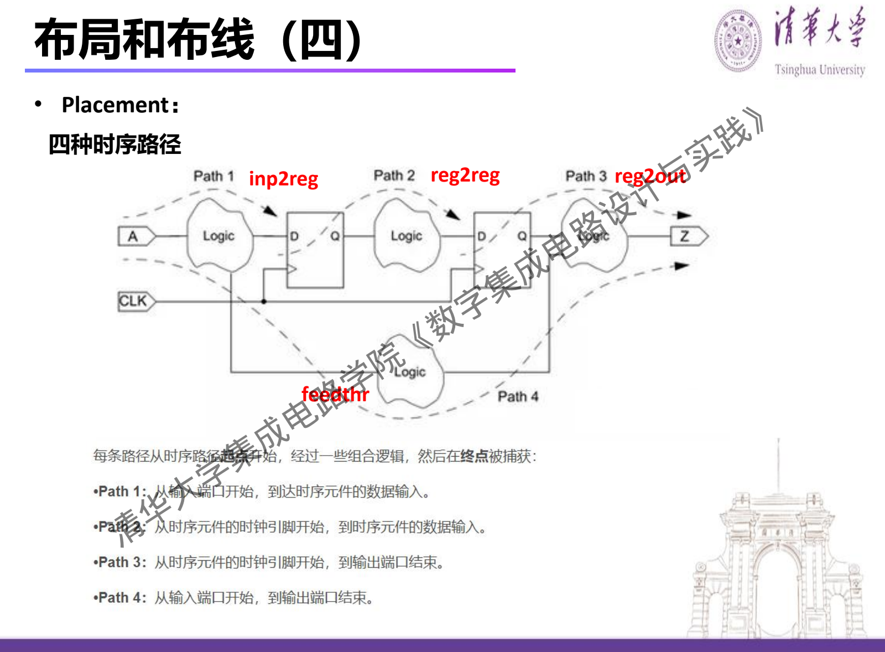
[picture p27: page 33]

- Placement：
四种时序路径
inp2reg

feedthr

reg2reg | reg2out

## 清华大学集成电路学院《数字集成电路设计与实践》

# 布局和布线（四）

- Placement：
运行脚本讲解 3

#Group Path setting

group_path -name reg2reg -from $reg -to $reg group_path -name reg2cg -from $reg -to $ckgating group_path -name in2reg -from $input
group_path -name reg2out -to $output group_path -name feedthr -from $input -to $output setPathGroupOptions reg2reg -effortLevel high setPathGroupOptions reg2cg -effortLevel high setPathGroupOptions in2reg -effortLevel low setPathGroupOptions reg2out -effortLevel low setPathGroupOptions feedthr -effortLevel low
setOptMode -ignorePathGroupsForHold $ignore_path_groups

./scripts/pr/placement.tcl

定义所有的路径类别

设置优化时序路径级别

忽略inp2reg、reg2out、feedthr的hold冲突

## 清华大学集成电路学院《数字集成电路设计与实践》

之前定义过

# 布局和布线（四）

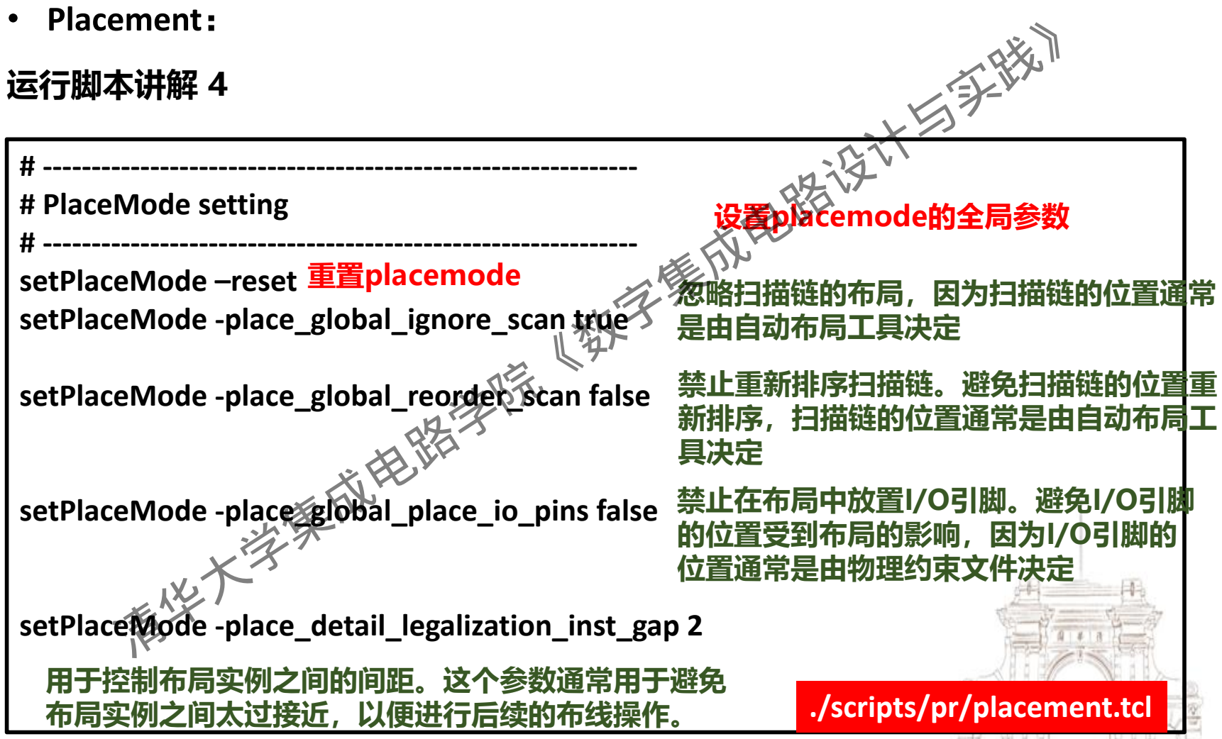
[picture p28: figure]
• Placement：; 运行脚本讲解 4; # ------------------------------------------------------------- # PlaceMode setting; # ------------------------------------------------------------- setPlaceMode –reset; setPlaceMode -place_global_ignore_scan true; setPlaceMode -place_global_reorder_scan false; setPlaceMode -place_global_place_io_pins false; setPlaceMode -place_detail_legalization_inst_gap 2; ./scripts/pr/placement.tcl; 重置placemode; 设置placemode的全局参数; 忽略扫描链的布局，因为扫描链的位置通常 是由自动布局工具决定; 禁止重新排序扫描链。避免扫描链的位置重 新排序，扫描链的位置通常是由自动布局工 具决定 禁止在布局中放置I/O引脚。避免I/O引脚 的位置受到布局的影响，因为I/O引脚的 位置通常是由物理约束文件决定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

# 布局和布线（四）

- Placement：
运行脚本讲解 5

# ------------------------------------------------------------- # global route layer setting

# ------------------------------------------------------------- setRouteMode -earlyGlobalMinRouteLayer $::env(MIN_GLOBAL_ROUTE_LAYER) - earlyGlobalMaxRouteLayer $::env(MAX_GLOBAL_ROUTE_LAYER)

setDesignMode -process $::env(PROCESS)
# ------------------------------------------------------------- # place the design & report congestion # ------------------------------------------------------------- place_opt_design reportCongestion -overflow

./scripts/pr/placement.tcl

设置全局路由层的范围。这个参数用于控
制电路的布线，以便在保证时序和功耗的
情况下，尽可能减少布线的层数。

全局路由层的最小/大层数，由
外界输入的两个环境变量控制
设置设计模式，包括工艺过程、电压和温度等参数。

执行布局placement操作

报告拥塞

## 清华大学集成电路学院《数字集成电路设计与实践》

情况，包括拥塞的单元格数量和拥塞的比例。用于评估电路的布局质量。

# 布局和布线（四）

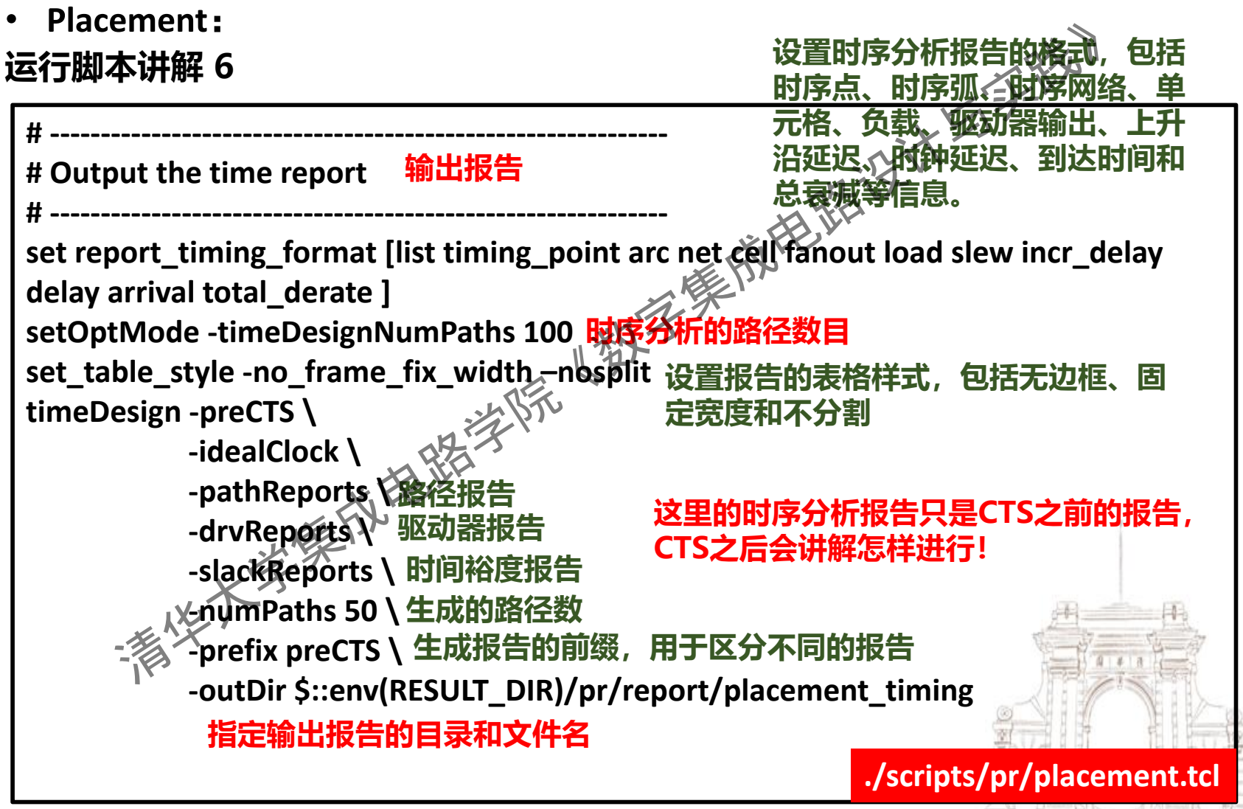
[picture p29: figure]
• Placement： 运行脚本讲解 6; delay arrival total_derate ] setOptMode -timeDesignNumPaths 100 set_table_style -no_frame_fix_width –nosplit timeDesign -preCTS \ -idealClock \ -pathReports \ -drvReports \ -slackReports \ -numPaths 50 \ -prefix preCTS \ -outDir $::env(RESULT_DIR)/pr/report/placement_timing; ./scripts/pr/placement.tcl; 输出报告; 设置时序分析报告的格式，包括 时序点、时序弧、时序网络、单 元格、负载、驱动器输出、上升 沿延迟、时钟延迟、到达时间和 总衰减等信息。; 设置报告的表格样式，包括无边框、固 定宽度和不分割; 时序分析的路径数目; 这里的时序分析报告只是CTS之前的报告， CTS之后会讲解怎样进行！; 路径报告 驱动器报告 时间裕度报告 生成的路径数 生成报告的前缀，用于区分不同的报告; 指定输出报告的目录和文件名; 清华大学集成电路学院《数字集成电路设计与实践》

# ------------------------------------------------------------- # Output the time report

# ------------------------------------------------------------- set report_timing_format [list timing_point arc net cell fanout load slew incr_delay

# 布局和布线（四）

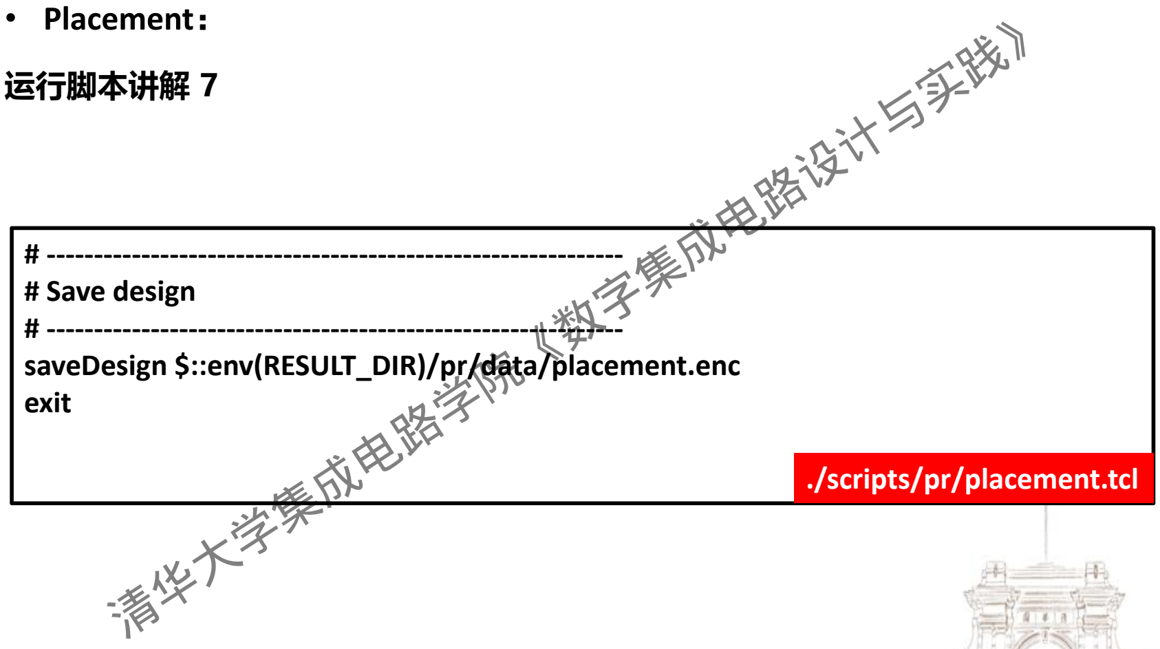
[picture p30: figure]
• Placement：; 运行脚本讲解 7; # ------------------------------------------------------------- # Save design; # ------------------------------------------------------------- saveDesign $::env(RESULT_DIR)/pr/data/placement.enc; exit; ./scripts/pr/placement.tcl; 清华大学集成电路学院《数字集成电路设计与实践》

# 布局和布线（四）

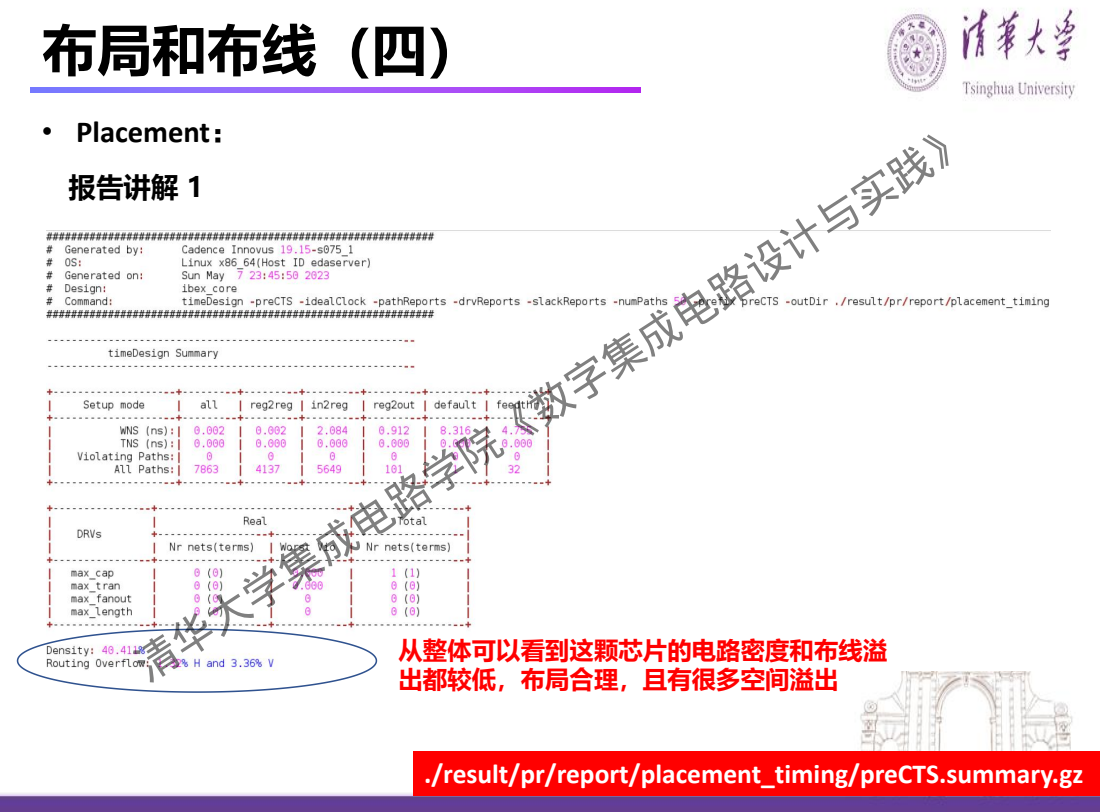
[picture p31: page 39]
• Placement：; 报告讲解 1; 清华大学集成电路学院《数字集成电路设计与实践》

从整体可以看到这颗芯片的电路密度和布线溢
出都较低，布局合理，且有很多空间溢出

./result/pr/report/placement_timing/preCTS.summary.gz

# 布局和布线（四）

- Placement：

1.Density（密度）：是指布局中使用的面积与可用面积之比。在布局过程中， 需要尽可能利用可用的面积，同时避免出现过于密集的布局，以免影响布线和 散热等因素。因此，Density通常用于评估布局的紧密程度和可用空间的利用率。 在timedesign报告中，Density通常以百分比的形式呈现，越接近100%表示布 局越紧密，越接近0%表示布局越松散。

2.Routing Overflow（布线溢出）：是指在布线过程中出现的信号线过长或过 多，导致无法在规定的布线层数内完成布线。在数字IC设计中，布线溢出通常 会导致电路的时序性能和功耗等方面的问题，因此需要进行优化和调整。在 timedesign报告中，Routing Overflow通常以拥塞比例的形式呈现，越接近 100%表示布线溢出越严重，需要进行优化和调整。

## 清华大学集成电路学院《数字集成电路设计与实践》

# 布局和布线（四）

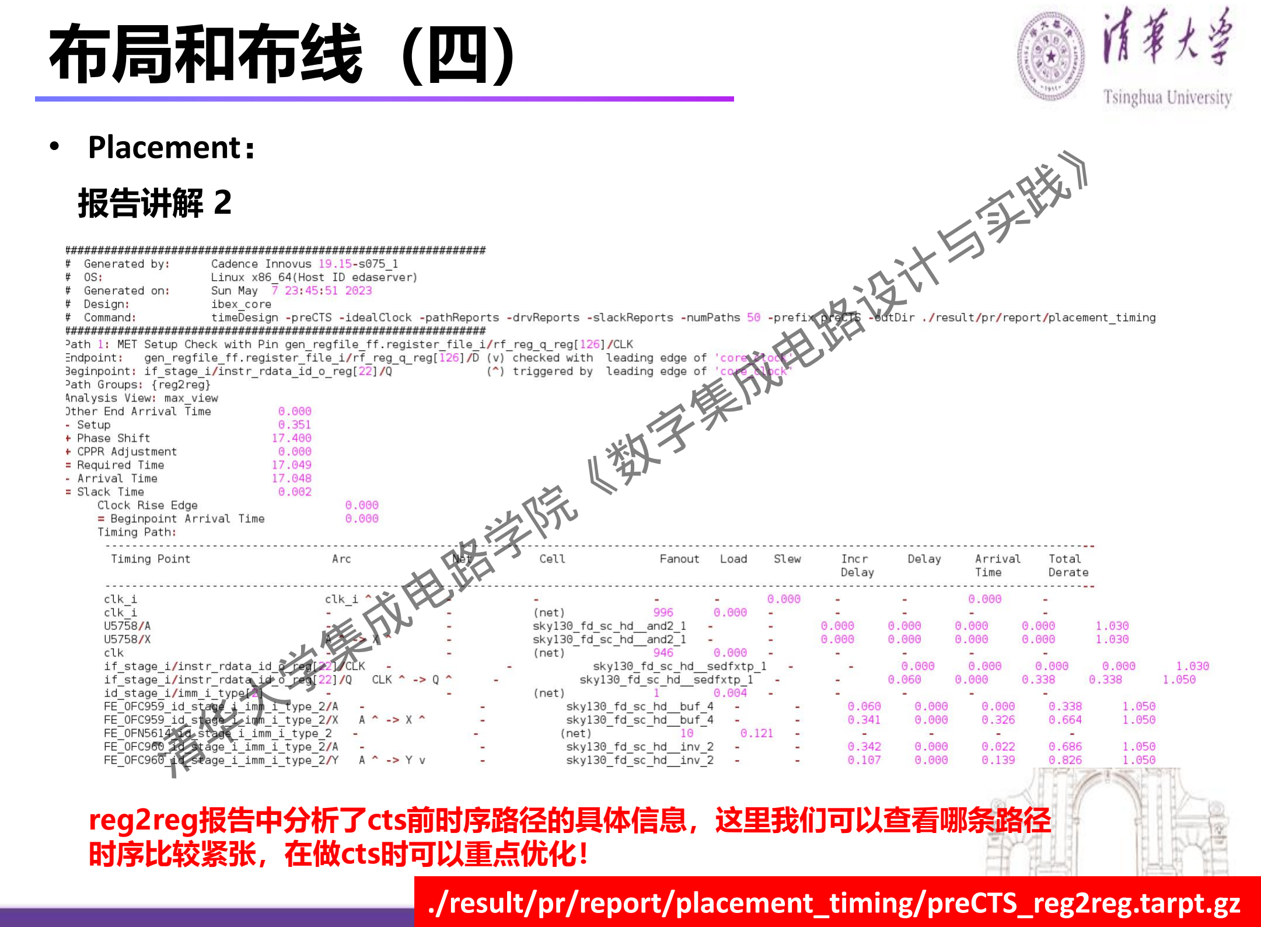
[picture p32: page 41]

- Placement：
报告讲解 2

reg2reg报告中分析了cts前时序路径的具体信息，这里我们可以查看哪条路径 时序比较紧张，在做cts时可以重点优化！
./result/pr/report/placement_timing/preCTS_reg2reg.tarpt.gz

## 清华大学集成电路学院《数字集成电路设计与实践》

# 布局和布线（四）

- 小结
- PR data init: 输出PR需要的必要文件
- Floor plan：完成芯片面积、形状的确立，并明确IO口的摆放
- Power plan：对芯片加入电源网络(VDD/VSS)规划，并进行连接性和 电源引脚短路检查
- Placement：将逻辑电路元件（如门、寄存器等）放置在芯片的物理 位置上，并进行电路密度和布线溢出检查、对关键路径进行分析， 为

## 清华大学集成电路学院《数字集成电路设计与实践》

下一步CTS做准备
