zuozhuyvzhibo-maker/Tinyriscv_g11/doc/Layout_instruction/DRC常见ERROR与解决方案.pdf

# DRC 常见 ERROR 与解决方案

# 1. 现阶段可 waive 的 DRC Error

可以 waive 的 DRC Error 列表如下

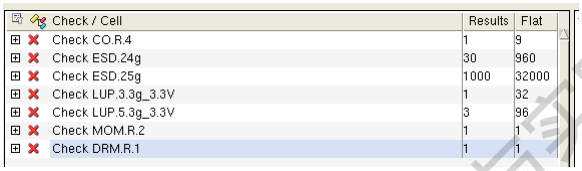
[picture p41: figure]

另外 ESD.WARN.4 也可 waive

# 1. 确定可 waive 的 DRC Error

# 1.1 MOM.R.2

MOM.R.2 { @ Each MOM cell must be covered by MOMDMY_n (n=145;1~6/100). DRC only flags no MOMDMY_n (n=145;1~6/100) in the chip. But if there is no MOM cell in your chip, the violation can be waived.
MERGE (CHIP NOT INTERACT MOMDMY_ALL)
}
由于我们是纯数字电路设计，并没有使用到 MOM，因此可 waived。

# 1.2 ESD.24g

ESD.24g { @ The minimum width of RPO on drain side (X) for 5V,3.3V, 2.5V, 1.8V and 1.5V NMOS and PMOS. @ exclude 1.8V and 1.5V NMOS when used as power clamp device>=1.95um X = ((ENSD_WCO OR EPSD_WCO ) AND ESD2DMY) AND RPO
Y = EGTE COIN OUTSIDE EDGE X
Z = RPO COIN INSIDE EDGE X
ENC Y Z < 1.95 ABUT < 90 REGION
}
IO 的 release note 中说明该 DRC ERROR 可 waive 来源：lib/IO/Documentation/release_note/rm_tpd018nv_280a.pdf

# 1.3 ESD.25g

ESD.25g { @ The minimum clearance from poly edge to CO edge on source side for NMOS and PMOS (Except ESD.26g)>=0.5um
X = ECOS AND ((ENMOS OR EPMOS ) INTERACT RPO)
EXT X EGTE_W < 0.5 ABUT < 90 OPPOSITE REGION
Y = ECO AND ESD1_NCS
EXT Y EGTE_W < 0.5 ABUT < 90 OPPOSITE REGION

# 数字集成电路设计与实践

}
IO 的 release note 中说明该 DRC ERROR 可 waive 来源：lib/IO/Documentation/release_note/rm_tpd018nv_280a.pdf

# 数字集成电路设计与实践

# 2. Seal Ring 相关的 DRC ERROR

# 2.1 SR.S.1

SR.S.1 { @ Minimum width of Assembly isolation >= ^SR_S_1 um ASS_REGION AND COi
ASS_REGION AND DNWi
ASS_REGION AND NWELi
ASS_REGION AND POLYi
ASS_REGION AND DPO
ASS_REGION AND ODi
ASS_REGION AND DOD
ASS_REGION AND VIA1i
ASS_REGION AND VIA2i
ASS_REGION AND VIA3i
ASS_REGION AND VIA4i
ASS_REGION AND VIA5i
ASS_REGION AND M1i
ASS_REGION AND M2i
ASS_REGION AND M3i
ASS_REGION AND M4i
ASS_REGION AND M5i
ASS_REGION AND M6i
ASS_REGION AND VIADi
ASS_REGION AND MDi
ASS_REGION AND UBMi
ASS_REGION AND CBDi
ASS_REGION AND CBi
}
DRC 要求芯片与 Seal Ring 之间最小要有 5um 的间隔，当间隔不足 5um 时则会出现该 Error，需要重新修改 Seal Ring，增大间隔。

# 2.2 DRC rule file 中 Seal Ring 选项未打开

出现下面的 ERROR 时，一般是 DRC rule file 中的选项不对，需要将其中的 FULL_CHIP 和 WITH_SEALRING 的注释删 掉

# 数字集成电路设计与实践

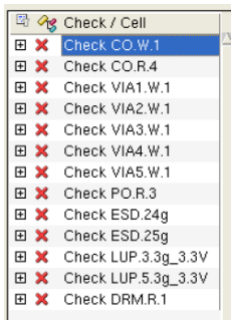
[picture p42: figure]
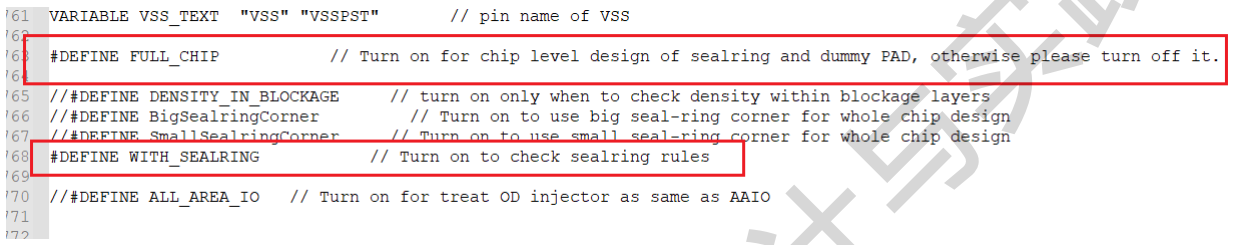
[picture p43: figure]

# 2.2 Seal Ring 重叠或缝隙

Seal Ring 不允许出现重叠或缝隙，若出现则会出现大量错误，类似下图。可以右键具体 ERROR，然后 highlight，即 可找到出现问题的地方

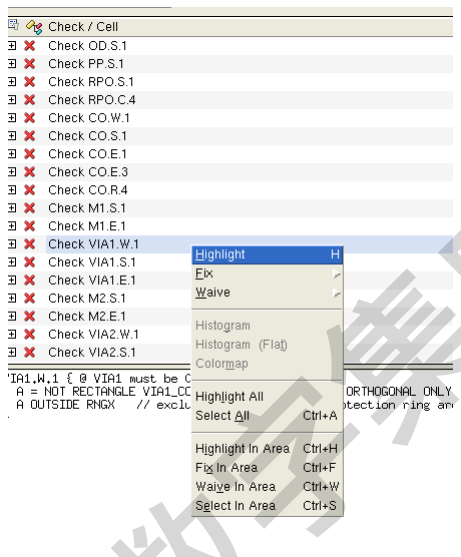
[picture p44: figure]

# 2.3 PO.R.5 或 PO.R.3

参考 DRC Error

# 数字集成电路设计与实践

解决-PO.R.5-更新 1009.pdf

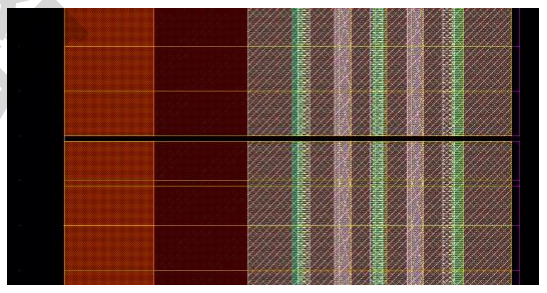
[picture p45: figure]

# 2.4 未加 Dummy OD

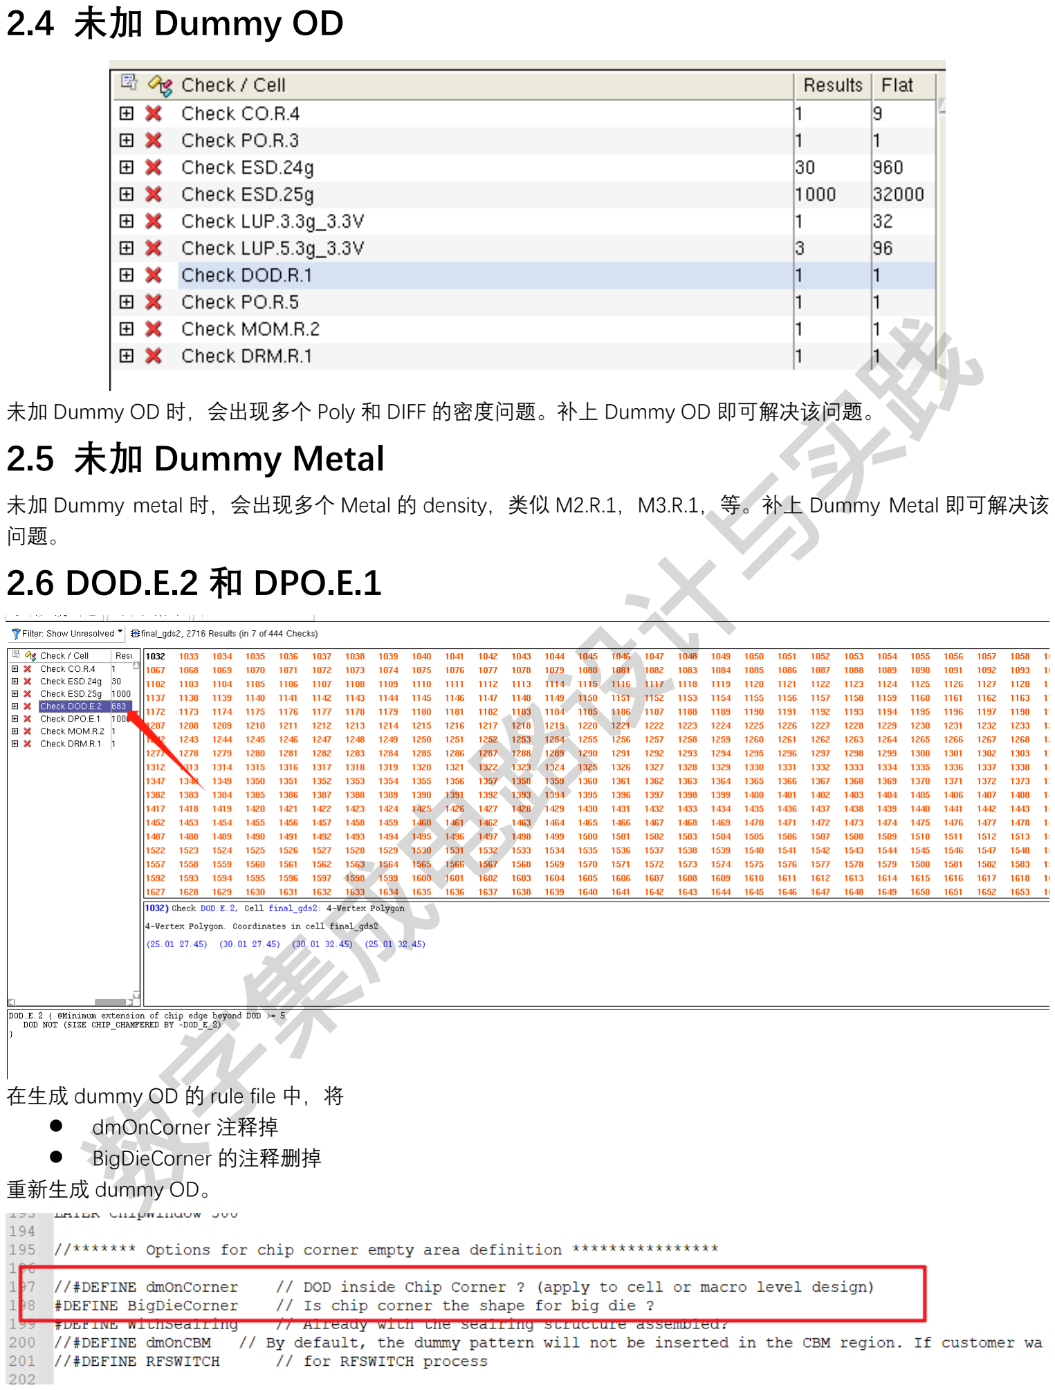
[picture p46: page 5]

未加 Dummy OD 时，会出现多个 Poly 和 DIFF 的密度问题。补上 Dummy OD 即可解决该问题。

# 2.5 未加 Dummy Metal

未加 Dummy metal 时，会出现多个 Metal 的 density，类似 M2.R.1，M3.R.1，等。补上 Dummy Metal 即可解决该 问题。

# 2.6 DOD.E.2 和 DPO.E.1

在生成 dummy OD 的 rule file 中，将
⚫ | dmOnCorner 注释掉
⚫ | BigDieCorner 的注释删掉
重新生成 dummy

# 数字集成电路设计与实践

OD。
