zuozhuyvzhibo-maker/Tinyriscv_g11/doc/Layout_instruction/LVS常见ERROR与解决方案.pdf

# LVS 常见 ERROR 与解决方案

# 1. Missing port

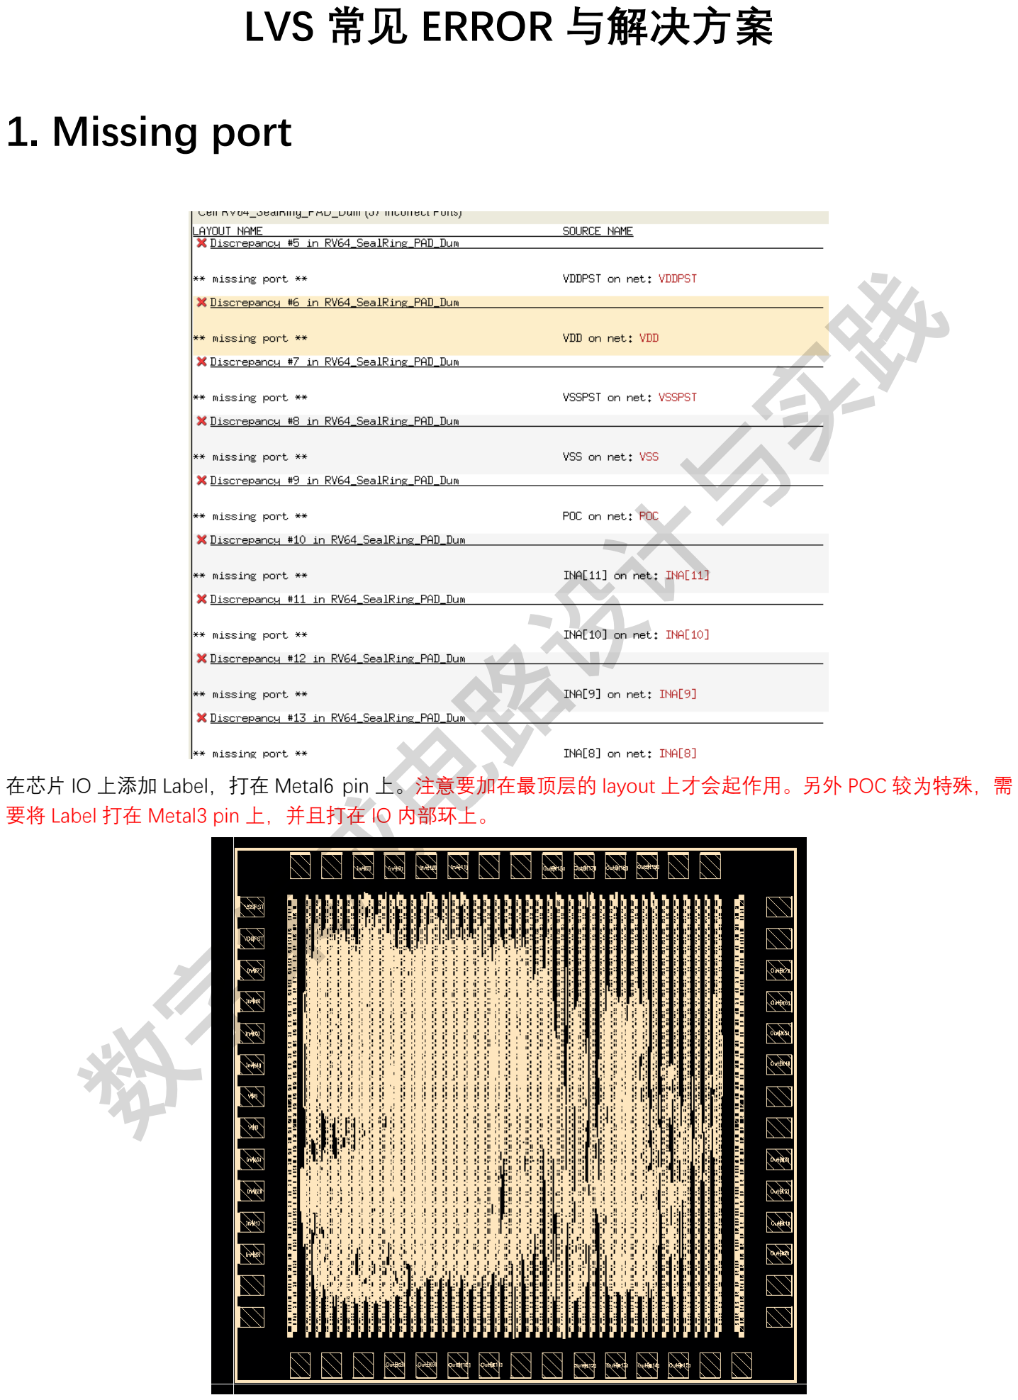
[picture p47: page 1]

在芯片 IO 上添加 Label，打在 Metal6 pin 上。注意要加在最顶层的 layout 上才会起作用。另外 POC 较为特殊，需 要将 Label 打在 Metal3 pin 上，并且打在 IO 内部环上。

# 数字集成电路设计与实践

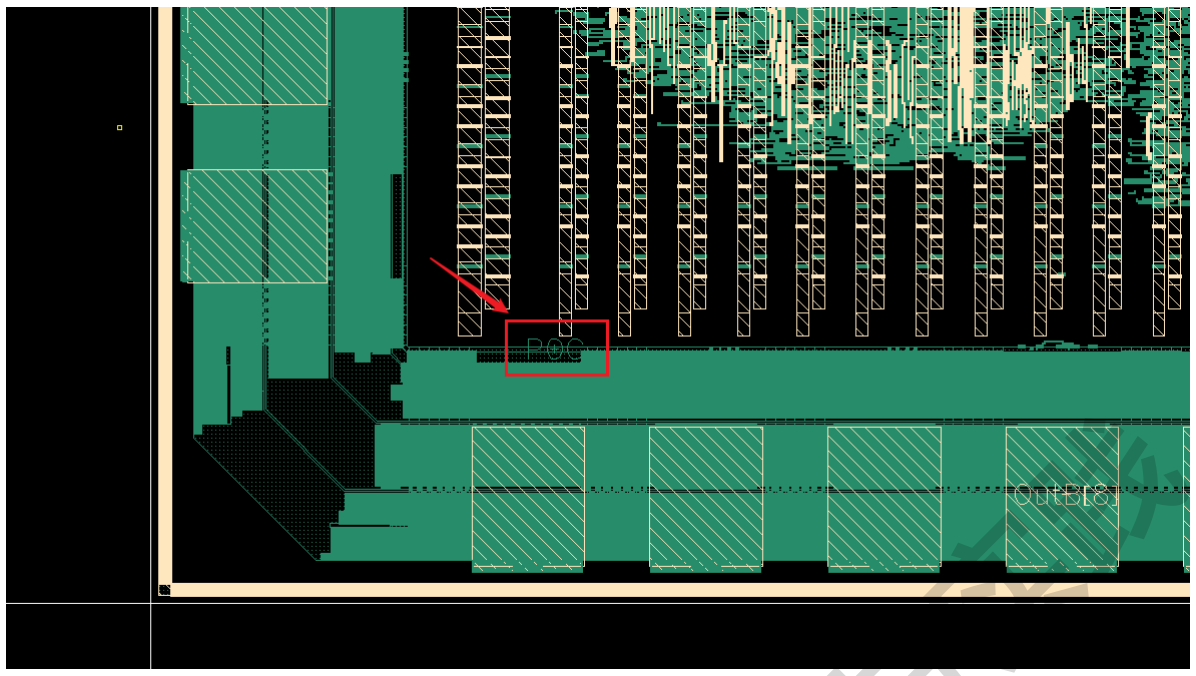
[picture p48: figure]

# 数字集成电路设计与实践

# 2. Property Error

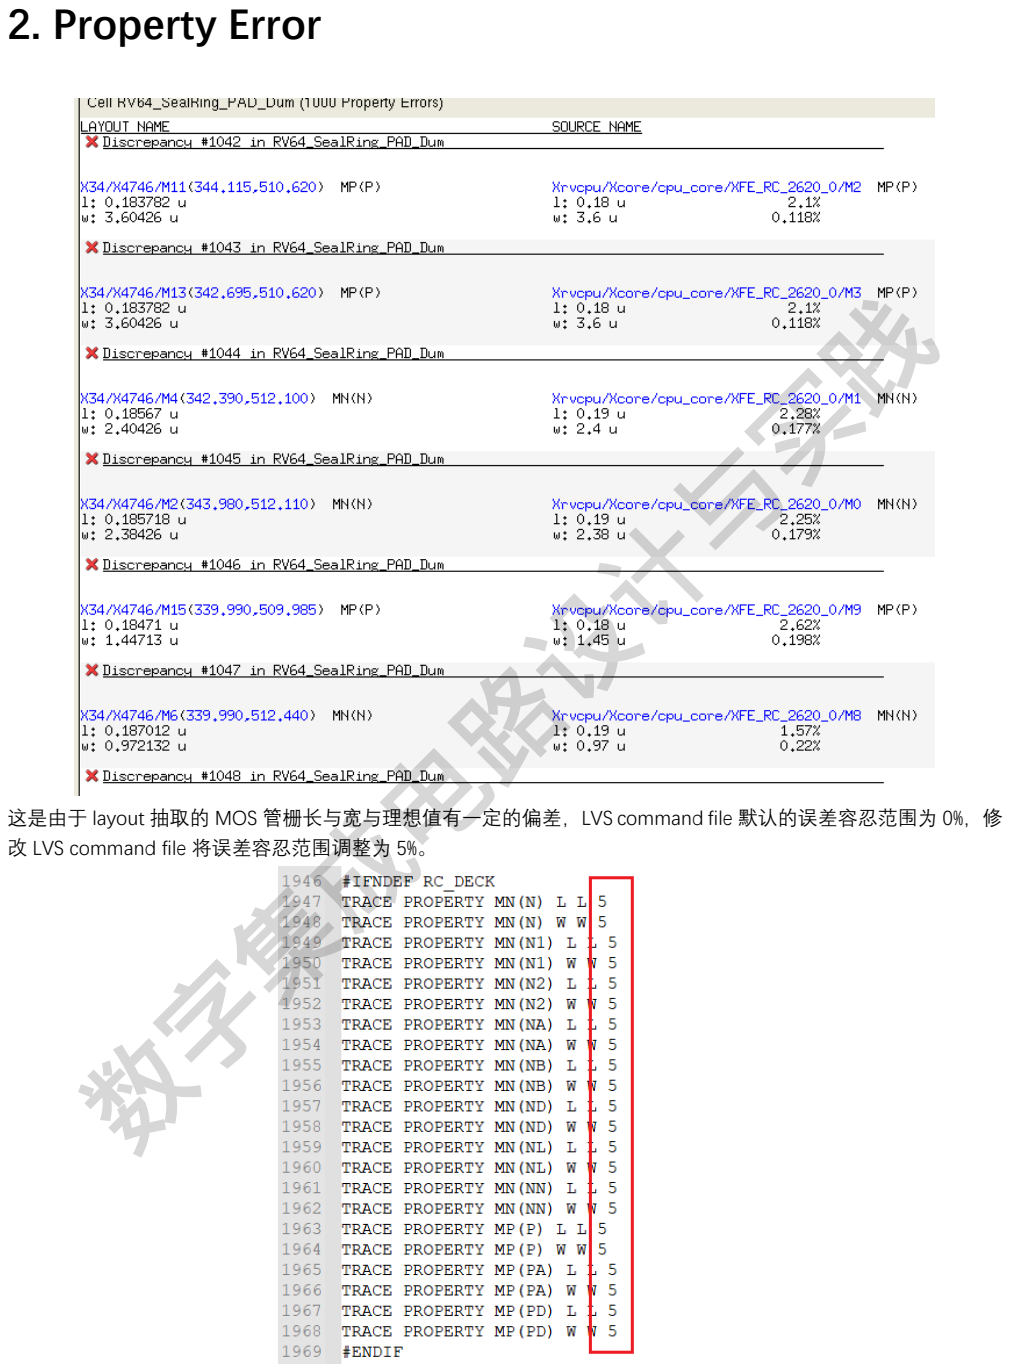
[picture p49: page 3]

这是由于 layout 抽取的 MOS 管栅长与宽与理想值有一定的偏差，LVS command file 默认的误差容忍范围为 0%，修 改 LVS command file 将误差容忍范围调整为 5%。

# 数字集成电路设计与实践

# 3. CASE SENSITIVE

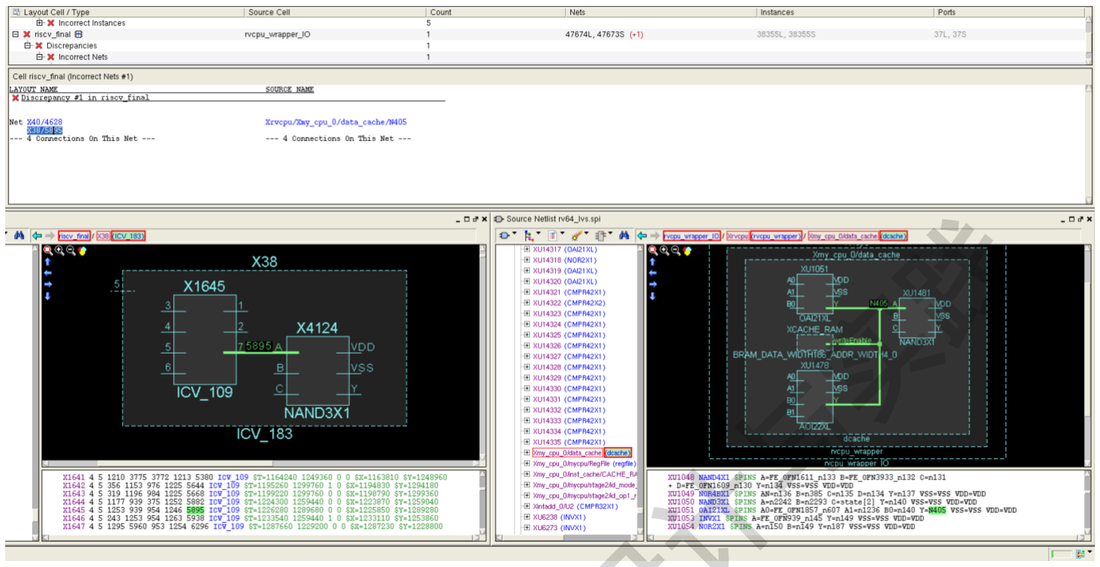
[picture p50: figure]

如上图所示，发现有部分连接关系错误，有可能是由于大小写的问题。导出的 SPI 文件默认是大小写敏感的，例如 上图中的例子中 N405 和 n405 本质上是两根信号线，但是 LVS 中大小写不敏感，导致将 N405 和 n405 认为为一个 信号线，导致出现连接错误。因此需要在 LVS command file 中加入下面三句语句

SOURCE CASE YES
LAYOUT CASE YES
LVS COMPARE CASE YES

# 数字集成电路设计与实践

# 4. IO 内部的 LVS 错误(可 waive)

在 PDDW0204CDG 内部出现的下述 ERROR 可以 waive

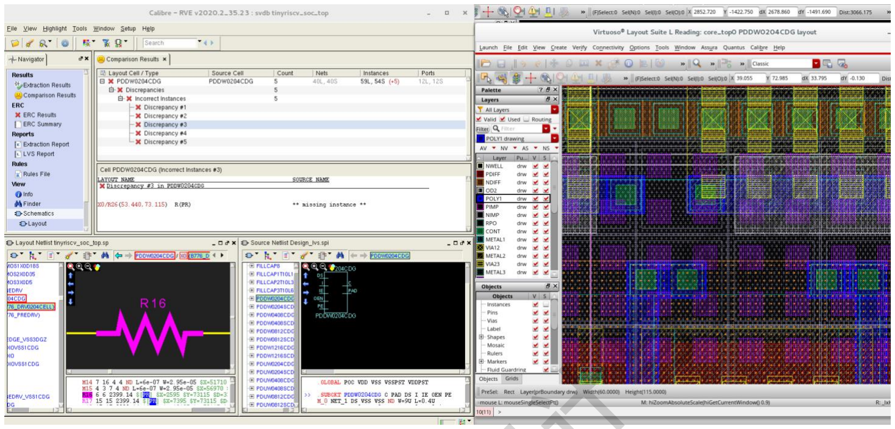
[picture p51: figure]

# 数字集成电路设计与实践
