zuozhuyvzhibo-maker/Tinyriscv_g11/rtl/merge_version/merge_version/lhr/verification/summary.md

# Stage-1 Icarus Regression Summary

- Date: 2026-07-27 15:26:58 +08:00
- Total: 27
- Passed: 27
- Failed: 0

| Test | Category | Result | Runtime (s) | Log |
| --- | --- | --- | ---: | --- |
| inst_add | BASIC | PASS | 0.452 | verification/logs/inst_add.log |
| inst_andi | BASIC | PASS | 0.268 | verification/logs/inst_andi.log |
| inst_auipc | BASIC | PASS | 0.104 | verification/logs/inst_auipc.log |
| inst_beq | BASIC | PASS | 0.409 | verification/logs/inst_beq.log |
| inst_bge | BASIC | PASS | 0.429 | verification/logs/inst_bge.log |
| inst_bgeu | BASIC | PASS | 0.454 | verification/logs/inst_bgeu.log |
| inst_blt | BASIC | PASS | 0.348 | verification/logs/inst_blt.log |
| inst_bltu | BASIC | PASS | 0.385 | verification/logs/inst_bltu.log |
| inst_bne | BASIC | PASS | 0.439 | verification/logs/inst_bne.log |
| inst_jal | BASIC | PASS | 0.104 | verification/logs/inst_jal.log |
| inst_jalr | BASIC | PASS | 0.176 | verification/logs/inst_jalr.log |
| inst_lui | BASIC | PASS | 0.116 | verification/logs/inst_lui.log |
| inst_ori | BASIC | PASS | 0.263 | verification/logs/inst_ori.log |
| inst_simple | BASIC | PASS | 0.079 | verification/logs/inst_simple.log |
| inst_slli | BASIC | PASS | 0.323 | verification/logs/inst_slli.log |
| inst_slti | BASIC | PASS | 0.338 | verification/logs/inst_slti.log |
| inst_sltiu | BASIC | PASS | 0.387 | verification/logs/inst_sltiu.log |
| inst_srai | BASIC | PASS | 0.307 | verification/logs/inst_srai.log |
| inst_srli | BASIC | PASS | 0.278 | verification/logs/inst_srli.log |
| inst_xori | BASIC | PASS | 0.288 | verification/logs/inst_xori.log |
| bridge_ram | BRIDGE_RAM | PASS | 0.084 | verification/logs/bridge_ram.log |
| m_removed | M_REMOVED | PASS | 0.103 | verification/logs/m_removed.log |
| rt_temperature | RT | PASS | 0.161 | verification/logs/rt_temperature.log |
| senid | SID | PASS | 1.807 | verification/logs/senid.log |
| if_instruction | IF | PASS | 0.078 | verification/logs/if_instruction.log |
| pwm_four_channel | PWM | PASS | 0.15 | verification/logs/pwm_four_channel.log |
| i2c_lm75 | I2C | PASS | 1.227 | verification/logs/i2c_lm75.log |
