zuozhuyvzhibo-maker/Tinyriscv_g11/rtl/merge_version/merge_version/verification/merge_regression_summary.txt

ChipSel Test        Kind  Pass Exit Log                                                                                
------- ----        ----  ---- ---- ---                                                                                
      0 inst_add    BASIC True    0 D:\liudk\project\tinyriscv_dk\tinyriscv\rtl_tomerge\rtl\merge_version\verificati...
      0 inst_andi   BASIC True    0 D:\liudk\project\tinyriscv_dk\tinyriscv\rtl_tomerge\rtl\merge_version\verificati...
      0 inst_auipc  BASIC True    0 D:\liudk\project\tinyriscv_dk\tinyriscv\rtl_tomerge\rtl\merge_version\verificati...
      0 inst_beq    BASIC True    0 D:\liudk\project\tinyriscv_dk\tinyriscv\rtl_tomerge\rtl\merge_version\verificati...
      0 inst_bge    BASIC True    0 D:\liudk\project\tinyriscv_dk\tinyriscv\rtl_tomerge\rtl\merge_version\verificati...
      0 inst_bgeu   BASIC True    0 D:\liudk\project\tinyriscv_dk\tinyriscv\rtl_tomerge\rtl\merge_version\verificati...
      0 inst_blt    BASIC True    0 D:\liudk\project\tinyriscv_dk\tinyriscv\rtl_tomerge\rtl\merge_version\verificati...
      0 inst_bltu   BASIC True    0 D:\liudk\project\tinyriscv_dk\tinyriscv\rtl_tomerge\rtl\merge_version\verificati...
      0 inst_bne    BASIC True    0 D:\liudk\project\tinyriscv_dk\tinyriscv\rtl_tomerge\rtl\merge_version\verificati...
      0 inst_jal    BASIC True    0 D:\liudk\project\tinyriscv_dk\tinyriscv\rtl_tomerge\rtl\merge_version\verificati...
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
      3 Temp        RT    True    0 D:\liudk\project\tinyriscv_dk\tinyriscv\rtl_tomerge\rtl\merge_version\verificati...
      3 PWM_inst    PWM   True    0 D:\liudk\project\tinyriscv_dk\tinyriscv\rtl_tomerge\rtl\merge_version\verificati...
