zuozhuyvzhibo-maker/Tinyriscv_g11/doc/远程登录服务器方法.pdf

# 数字集成电路设计与实践实验指导书

## 远程登陆服务器方法

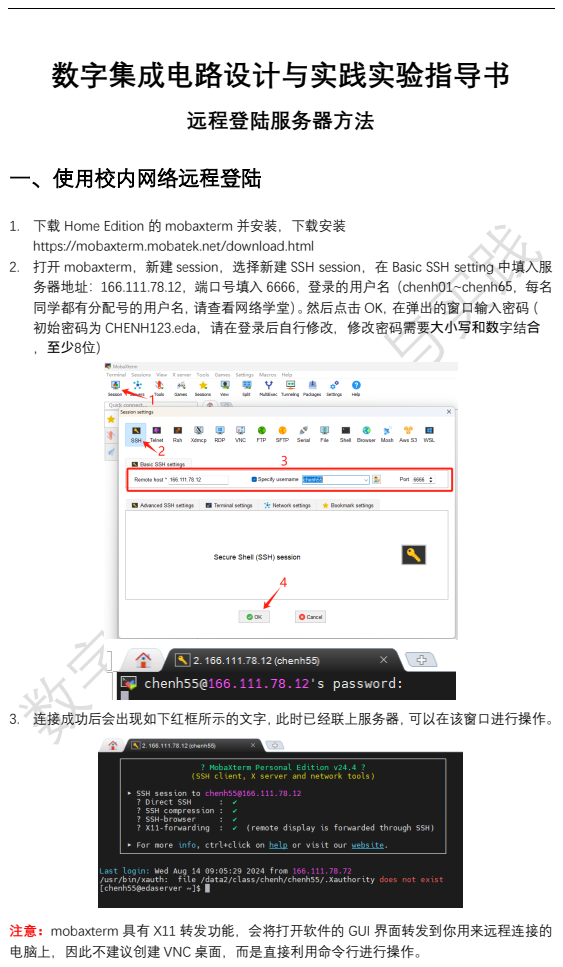
[picture p71: page 1]
一、使用校内网络远程登陆; 桌面，而是直接利用命令行进行操作。

1. 下载 Home Edition 的 mobaxterm 并安装，下载安装
https://mobaxterm.mobatek.net/download.html
2. 打开 mobaxterm，新建 session，选择新建 SSH session，在 Basic SSH setting 中填入服
务器地址：166.111.78.12，端口号填入 6666，登录的用户名（chenh01~chenh65，每名
同学都有分配号的用户名，请查看网络学堂）。然后点击 OK，在弹出的窗口输入密码（
初始密码为 CHENH123.eda，请在登录后自行修改修改密码需要大小写和数字结合

3. 连接成功后会出现如下红框所示的文字，此时已经联上服务器，可以在该窗口进行操作。

注意：mobaxterm 具有 X11 转发功能，会将打开软件的 GUI 界面转发到你用来远程连接的
电脑上，因此不建议创建 VNC

## 二、使用校外网络进行远程连接

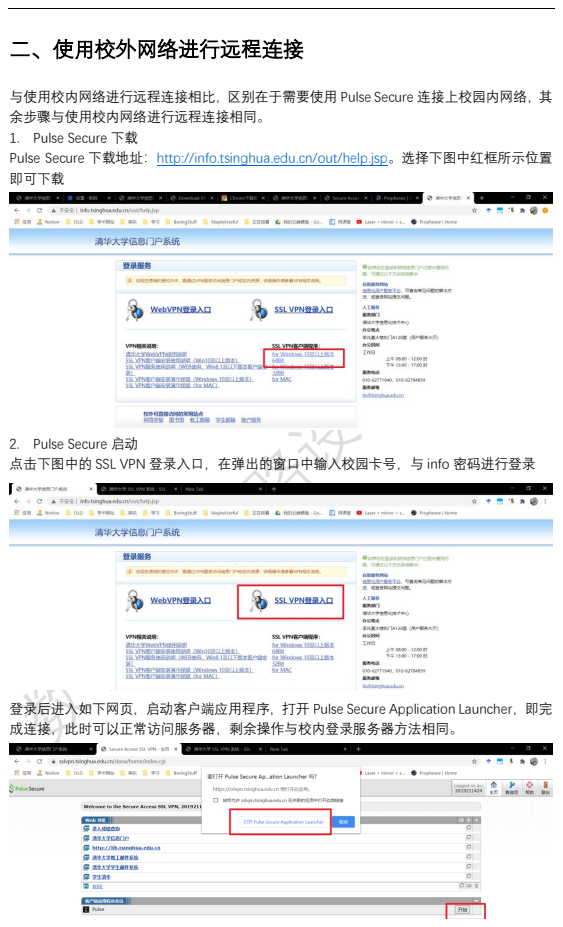
[picture p72: page 2]

与使用校内网络进行远程连接相比，区别在于需要使用 Pulse Secure 连接上校园内网络，其
余步骤与使用校内网络进行远程连接相同。
1. Pulse Secure 下载
Pulse Secure 下载地址：http://info.tsinghua.edu.cn/out/help.jsp。选择下图中红框所示位置
即可下载

2. Pulse Secure 启动
点击下图中的 SSL VPN 登录入口，在弹出的窗口中输入校园卡号，与 info 密码进行登录

登录后进入如下网页，启动客户端应用程序，打开 Pulse Secure Application Launcher，即完
成连接，此时可以正常访问服务器，剩余操作与校内登录服务器方法相同。

## 三、创建 VNC 桌面

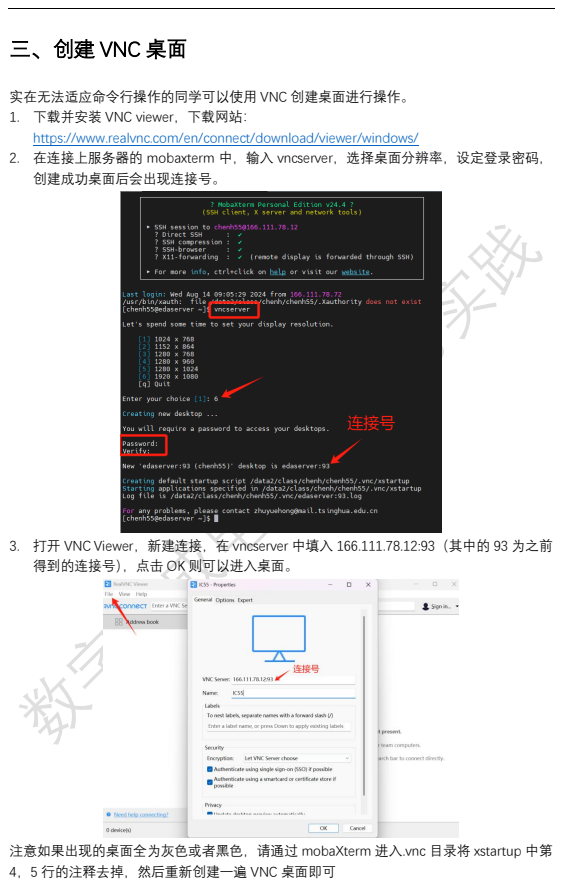
[picture p73: page 3]

实在无法适应命令行操作的同学可以使用 VNC 创建桌面进行操作。
1. 下载并安装 VNC viewer，下载网站：
https://www.realvnc.com/en/connect/download/viewer/windows/
2. 在连接上服务器的 mobaxterm 中，输入 vncserver，选择桌面分辨率，设定登录密码，
创建成功桌面后会出现连接号。

3. 打开 VNC Viewer，新建连接，在 vncserver 中填入 166.111.78.12:93（其中的 93 为之前
得到的连接号），点击 OK 则可以进入桌面。

注意如果出现的桌面全为灰色或者黑色，请通过 mobaXterm 进入.vnc 目录将 xstartup 中第
4，5 行的注释去掉，然后重新创建一遍 VNC 桌面即可

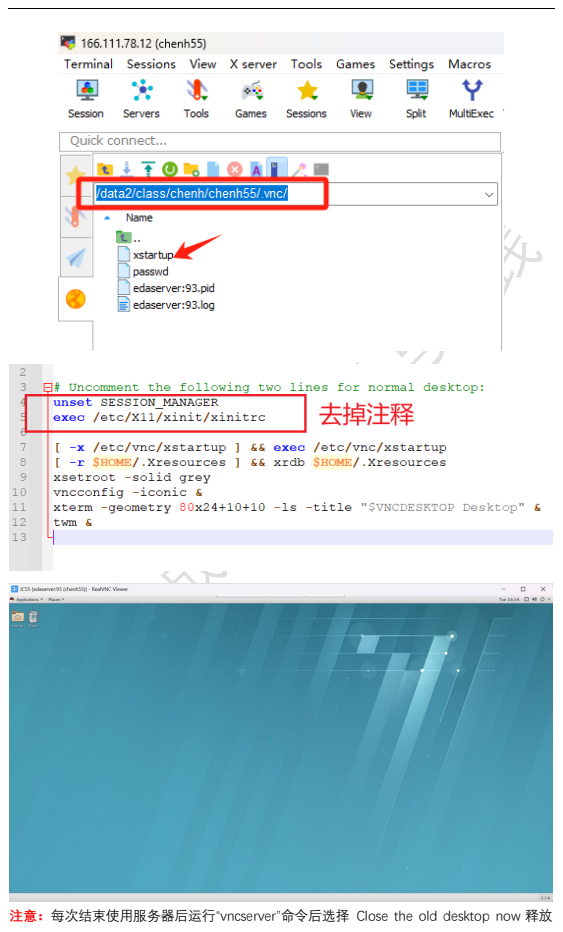
[picture p74: page 4]

注意：每次结束使用服务器后运行“vncserver”命令后选择 Close the old desktop now 释放

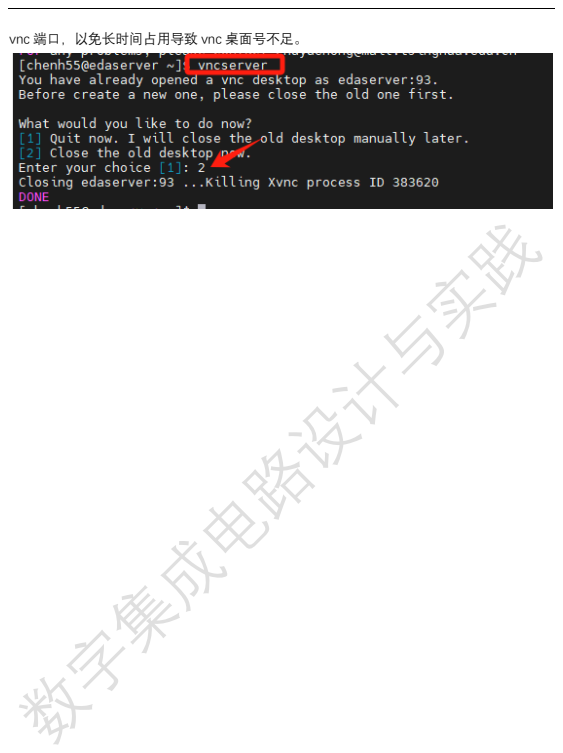
[picture p75: page 5]

vnc 端口，以免长时间占用导致 vnc 桌面号不足。
