zuozhuyvzhibo-maker/Tinyriscv_g11/rtl/merged_freeze/rtl/merged/rtl/cores/ldk/core/rib.v

 /*
 Copyright 2020 Blue Liang, liangkangnan@163.com

 Licensed under the Apache License, Version 2.0 (the "License");
 you may not use this file except in compliance with the License.
 You may obtain a copy of the License at

     http://www.apache.org/licenses/LICENSE-2.0

 Unless required by applicable law or agreed to in writing, software
 distributed under the License is distributed on an "AS IS" BASIS,
 WITHOUT WARRANTIES OR CONDITIONS OF ANY KIND, either express or implied.
 See the License for the specific language governing permissions and
 limitations under the License.
 */

`include "ldk_defs.v"



// LDK-prefixed private RTL module for the four-core integration.
module ldk_rib(

    input wire clk,
    input wire rst,

    // master 0 interface
    input wire[`LDK_MemAddrBus] m0_addr_i,
    input wire[`LDK_MemBus] m0_data_i,
    output reg[`LDK_MemBus] m0_data_o,
    input wire m0_req_i,
    input wire m0_we_i,
    output reg m0_ack_o,

    // master 1 interface
    input wire[`LDK_MemAddrBus] m1_addr_i,
    input wire[`LDK_MemBus] m1_data_i,
    output reg[`LDK_MemBus] m1_data_o,
    input wire m1_req_i,
    input wire m1_we_i,
    output reg m1_ack_o,

    // master 2 interface
    input wire[`LDK_MemAddrBus] m2_addr_i,
    input wire[`LDK_MemBus] m2_data_i,
    output reg[`LDK_MemBus] m2_data_o,
    input wire m2_req_i,
    input wire m2_we_i,

    // master 3 interface
    input wire[`LDK_MemAddrBus] m3_addr_i,
    input wire[`LDK_MemBus] m3_data_i,
    output reg[`LDK_MemBus] m3_data_o,
    input wire m3_req_i,
    input wire m3_we_i,
    output reg m3_ack_o,

    // slave 0 interface
    output reg[`LDK_MemAddrBus] s0_addr_o,
    output reg[`LDK_MemBus] s0_data_o,
    input wire[`LDK_MemBus] s0_data_i,
    output reg s0_we_o,
    output reg s0_req_o,
    input wire s0_ack_i,

    // slave 1 interface
    output reg[`LDK_MemAddrBus] s1_addr_o,
    output reg[`LDK_MemBus] s1_data_o,
    input wire[`LDK_MemBus] s1_data_i,
    output reg s1_we_o,
    input wire s1_ack_i,

    // slave 2 interface
    output reg[`LDK_MemAddrBus] s2_addr_o,
    output reg[`LDK_MemBus] s2_data_o,
    input wire[`LDK_MemBus] s2_data_i,
    output reg s2_we_o,

    // slave 3 interface
    output reg[`LDK_MemAddrBus] s3_addr_o,
    output reg[`LDK_MemBus] s3_data_o,
    input wire[`LDK_MemBus] s3_data_i,
    output reg s3_we_o,

    // slave 4 interface
    output reg[`LDK_MemAddrBus] s4_addr_o,
    output reg[`LDK_MemBus] s4_data_o,
    input wire[`LDK_MemBus] s4_data_i,
    output reg s4_we_o,

    // slave 5 interface
    output reg[`LDK_MemAddrBus] s5_addr_o,
    output reg[`LDK_MemBus] s5_data_o,
    input wire[`LDK_MemBus] s5_data_i,
    output reg s5_we_o,

    // slave 6 interface
    output reg[`LDK_MemAddrBus] s6_addr_o,
    output reg[`LDK_MemBus] s6_data_o,
    input wire[`LDK_MemBus] s6_data_i,
    output reg s6_we_o,

    // slave 7 interface
    output reg s7_req_o,
    output reg[`LDK_MemAddrBus] s7_addr_o,
    output reg[`LDK_MemBus] s7_data_o,
    input wire[`LDK_MemBus] s7_data_i,
    output reg s7_we_o,
    input wire s7_ack_i,

    output reg hold_flag_o

    );




    parameter [3:0]slave_0 = 4'b0000;
    parameter [3:0]slave_1 = 4'b0001;
    parameter [3:0]slave_2 = 4'b0010;
    parameter [3:0]slave_3 = 4'b0011;
    parameter [3:0]slave_4 = 4'b0100;
    parameter [3:0]slave_5 = 4'b0101;
    parameter [3:0]slave_6 = 4'b0110;
    parameter [3:0]slave_7 = 4'b0111;

    parameter [1:0]grant0 = 2'h0;
    parameter [1:0]grant1 = 2'h1;
    parameter [1:0]grant2 = 2'h2;
    parameter [1:0]grant3 = 2'h3;

    wire[3:0] req;
    reg[1:0] grant;



    assign req = {m3_req_i, m2_req_i, m1_req_i, m0_req_i};




    always @ (*) begin
        if (req[3]) begin
            grant = grant3;
            hold_flag_o = `LDK_HoldEnable;
        end else if (req[0]) begin
            grant = grant0;
            hold_flag_o = `LDK_HoldEnable;
        end else if (req[2]) begin
            grant = grant2;
            hold_flag_o = `LDK_HoldEnable;
        end else begin
            grant = grant1;
            hold_flag_o = `LDK_HoldDisable;
        end
    end


    always @ (*) begin
        m0_data_o = `LDK_ZeroWord;
        m1_data_o = `LDK_INST_NOP;
        m2_data_o = `LDK_ZeroWord;
        m3_data_o = `LDK_ZeroWord;

        m0_ack_o = `LDK_AckDisable;
        m1_ack_o = `LDK_AckDisable;
        m3_ack_o = `LDK_AckDisable;

        s0_addr_o = `LDK_ZeroWord;
        s1_addr_o = `LDK_ZeroWord;
        s2_addr_o = `LDK_ZeroWord;
        s3_addr_o = `LDK_ZeroWord;
        s4_addr_o = `LDK_ZeroWord;
        s5_addr_o = `LDK_ZeroWord;
        s6_addr_o = `LDK_ZeroWord;
        s7_addr_o = `LDK_ZeroWord;
        s0_data_o = `LDK_ZeroWord;
        s1_data_o = `LDK_ZeroWord;
        s2_data_o = `LDK_ZeroWord;
        s3_data_o = `LDK_ZeroWord;
        s4_data_o = `LDK_ZeroWord;
        s5_data_o = `LDK_ZeroWord;
        s6_data_o = `LDK_ZeroWord;
        s7_data_o = `LDK_ZeroWord;
        s0_we_o = `LDK_WriteDisable;
        s1_we_o = `LDK_WriteDisable;
        s2_we_o = `LDK_WriteDisable;
        s3_we_o = `LDK_WriteDisable;
        s4_we_o = `LDK_WriteDisable;
        s5_we_o = `LDK_WriteDisable;
        s6_we_o = `LDK_WriteDisable;
        s7_we_o = `LDK_WriteDisable;

        s0_req_o = `LDK_RIB_NREQ;
        s7_req_o = `LDK_RIB_NREQ;


        case (grant)
            grant0: begin
                case (m0_addr_i[31:28])
                    slave_0: begin
                        s0_we_o = m0_we_i;
                        s0_req_o = m0_req_i; // --liudk 2026-05-05
                        s0_addr_o = m0_addr_i;
                        s0_data_o = m0_data_i;
                        m0_data_o = s0_data_i;
                        m0_ack_o = s0_ack_i; // --liudk 2026-05-13
                    end
                    slave_1: begin
                        s0_we_o = m0_we_i;
                        s0_req_o = m0_req_i; // --liudk 2026-05-05
                        s0_addr_o = m0_addr_i;
                        s0_data_o = m0_data_i;
                        m0_data_o = s0_data_i;
                        m0_ack_o = s0_ack_i; // --liudk 2026-05-13
                    end
                    slave_2: begin
                        s2_we_o = m0_we_i;
                        s2_addr_o = {{4'h0}, {m0_addr_i[27:0]}};
                        s2_data_o = m0_data_i;
                        m0_data_o = s2_data_i;
                    end
                    slave_3: begin
                        s3_we_o = m0_we_i;
                        s3_addr_o = {{4'h0}, {m0_addr_i[27:0]}};
                        s3_data_o = m0_data_i;
                        m0_data_o = s3_data_i;
                    end
                    slave_4: begin
                        s4_we_o = m0_we_i;
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
                        m3_data_o = s7_data_i;
                        m3_ack_o = s7_ack_i;
                    end
                    default: begin

                    end
                endcase
            end
            default: begin

            end
        endcase
    end

endmodule
