zuozhuyvzhibo-maker/Tinyriscv_g11/(commit log)

2026-07-23 Fourth Test
    [服务器账号分配.xlsx]
2026-07-27 Add LHR reduced RTL and verification package
    [results.csv]
2026-08-04 Verrion1: first merged rtl
    [DRC_Table.xlsx, Table.xlsx, results.csv]
2026-08-04 Add frozen four-core RTL release package
    [results.csv]
